donnels/aiwa-pb-3/README.asciidoc

= aiwa pb-3 battery replacement
:toc: right
:toclevels: 5
:sectnums:
:sectnumlevels: 5
:flag-book: true

USB-C rechargeable LiPo replacement for the AIWA PB-3/PB-4 battery pack.

[NOTE]
====
This is a personal project, not affiliated with or endorsed by AIWA.
This is my first outing with KICAD and PCB design; forgive stupidity and ignorance.
====

== Specs

|===
| Parameter | Original PB-3 | This Design
| Chemistry | Lead-acid | LiPo
| Cell voltage | 2V | 3.7V nominal
| Output voltage | 2V | 2.0V (adjustable 2.0-2.4V)
| Capacity | 470mAh | 500-1500mAh
| Charging | Proprietary | USB-C 5V
|===

== Safety

* Buck DC-DC steps 3.7V → 2.4V
* **OVP (Zener/TVS)** clamps output <3V if buck fails
* DW01A+FS8205A BMS: OV/UV/OC protection

== How This Book Is Built

This README is a step-by-step training example: it walks from raw
research to a working, physically- and electrically-compliant battery
pack, including the toolchain checks done along the way. Every step below
is its own `README.adoc` in its own directory, assembled here with
`include::` and `leveloffset` — nothing is a link, so the whole story
reads top to bottom in one document.

. *Research* — collect teardown photos, forum knowledge, and IC datasheets.
. *Measurements* — caliper the original pack and derive the mechanical envelope.
. *Design Notebook* — turn research and measurements into requirements.
. *KiCad Hello World* — prove the KiCad → KiBot → CI toolchain on a known-good project.
. *Mechanical Design* — OpenSCAD fit-check model of the envelope.
. *Circuit Design & Emulation* — KiCad schematic, component selection, ngspice model.
. *Architecture Diagrams* — PlantUML system diagrams.
. *Results & Compliance* — generated evidence that the design fits and works.

== Step 1: Research

include::research/README.adoc[leveloffset=+2]

== Step 2: Measurements

include::measurements/README.adoc[leveloffset=+2]

== Step 3: Design Notebook

include::pb3-notes.adoc[leveloffset=+2]

== Step 4: KiCad Hello World

include::kicad-hello-world/README.adoc[leveloffset=+2]

== Step 5: Mechanical Design (OpenSCAD)

include::openscad/README.adoc[leveloffset=+2]

== Step 6: Circuit Design & Emulation (KiCad)

include::kicad/README.adoc[leveloffset=+2]

== Step 7: Architecture Diagrams

include::images/README.adoc[leveloffset=+2]

== Step 8: Results & Compliance

include::results/README.adoc[leveloffset=+2]

== Architecture Decisions

include::adr/README.adoc[leveloffset=+2]

== Credits

* https://stereo2go.com/forums/threads/rechargeable-battery-replacement-for-aiwa-pb-3-pb-4.9025/[Stereo2Go forum] — original research
* OpenSCAD: https://github.com/donnels/openscad[ghcr.io/donnels/openscad:main]
* PlantUML: https://github.com/donnels/plantuml[ghcr.io/donnels/plantuml:main]
* KiBot: https://github.com/INTI-CMNB/KiBot[INTI-CMNB/KiBot@v2_dk8]

== Containerized builds

Every step in the `Build` workflow runs in a container — OpenSCAD,
PlantUML, KiCad, AsciiDoc, ngspice, and the GLB→STL board conversion.
Nothing installs directly on the runner. Generated renders, diagrams,
fabrication files, simulation logs, and documents are committed under
`results/`. Locally-built images (ngspice, trimesh) and their Dockerfiles
live in `containers/`, each with its own README.
