donnels/aiwa-pb-3/kicad/README.adoc

= Circuit Design & Emulation
ifndef::flag-book[]
:toc: right
:toclevels: 5
:sectnums:
:sectnumlevels: 5
endif::[]
ifdef::flag-book[]
:imagesdir-save: {imagesdir}
:imagesdir: kicad
endif::[]

`pb3-replacement.kicad_pro` (with its `.kicad_sch`/`.kicad_pcb`) is the
living electrical design for the replacement pack: a 68×17.8×8mm board that
takes USB-C 5V in and delivers a regulated 2.0-2.4V deck rail from a 1S
LiPo cell.

== Component Selection

Each part below was picked from the candidates surveyed in
`research/README.adoc`, chosen for SOT-23-6 footprints (small enough for
the enclosure) and for matching the behavior already proven on the clone
teardown boards.

CN3058E (charger)::
Linear Li-ion/LiPo charge management IC. Takes the USB-C 5V rail, applies
CC/CV charging to the cell, and needs only a handful of external passives
— important with almost no board area to spare.

DW01A + FS8205A (protection)::
Discrete battery management system on the cell tabs. DW01A senses cell
voltage and current; FS8205A is the dual N-MOSFET it drives to cut the
path on overvoltage, undervoltage, or overcurrent/short. Chosen instead of
trusting the charger or buck stage alone, so a fault anywhere downstream
still leaves the cell protected.

Buck regulator (TPS61023-class)::
Steps the ~3.7V cell rail down to the 2.0-2.4V the deck expects. The
feedback resistor sets the output: 100kΩ gives the PB-S5 clone's default
2.4V; the forum's 120kΩ swap gives 2.1V. Extrapolating those two points
puts 2.0V at roughly 130kΩ — an unverified estimate, not a datasheet
value. `pb3-architecture-sizing.cir` models 2.0V directly; confirm the
real resistor against the vendor datasheet and bench measurement before
fabrication.

OVP clamp (Zener/TVS)::
Added on top of what the clone boards do: clamps the output below 3V if
the buck stage fails, so the deck never sees the raw 3.7V cell rail.

== Circuit Emulation

Emulation happens in two stages so a passing simulation always means
something about the *real* board, not just about an idealized stand-in.
See `pb3-notes.adoc`'s "Verification Chain" for how this fits the
project's broader print/fit/design/verify sequence.

=== Stage 1 — Architecture Sizing (exploratory, not a verification)

`pb3-architecture-sizing.cir` is a system-level ngspice model used to
pick topology and nominal values *before* the schematic below existed.
It approximates the CN3058E charger, 1S LiPo, DW01A/FS8205A protection,
2.0V buck regulator, 200mA deck load, and output clamp with behavioral
sources (idealized voltages/thresholds, not real part models). It is
useful for checking operating points and assumptions. It does **not**
validate the real IC compensation network, stability, thermal behavior,
the unverified AIWA connector pinout, or — critically — the actual
schematic/PCB below: the netlist is hand-written, independent of
`pb3-replacement.kicad_sch`, so a passing run only proves the idealized
model is self-consistent.

Run it with ngspice:

[source,bash]
----
ngspice -b -o pb3-architecture-sizing.log pb3-architecture-sizing.cir
grep -E 'vout_|load_current|vbat' pb3-architecture-sizing.log
----

Expected results: ~1.98V at the deck output, 198mA load current, 3.7V
at the idealized cell. The model hard-codes a 2.0V buck target — it
does not use the ~130kΩ feedback-resistor estimate above, which is for
the real IC's feedback divider, not this behavioral model.

=== Stage 2 — Schematic-Derived Simulation (netlist export unblocked; full SPICE sim still partial)

The step that actually verifies the design generates a SPICE netlist
*from* `pb3-replacement.kicad_sch` (`kicad-cli sch export netlist
--format spice`) and simulates it with real or vendor-published SPICE
models for `U1` (TP4056), `U2` (DW01A), `Q1` (FS8205A substitute, see
below), `U3` (TPS62200), and `D1` (Zener) wherever such models exist.
That checks the same reference designators and values that get
fabricated, closing the gap that Stage 1 leaves open.

`pb3-replacement.kicad_sch` is now a real, pin-wired schematic instead of
a block/documentation diagram: every component is a real KiCad library
symbol (embedded in `lib_symbols`), and every pin is tied to its net via a
same-named global label placed at the pin, reusing the exact net names
already routed on the PCB (`VBUS`, `VBAT`, `VBAT_RAW_NEG`, `GND`,
`OD`/`OC`) plus new nets for the passives the PCB was missing (see "PCB
Routing" below). `kicad-cli sch erc` on this schematic reports **0
errors** (down from 19 dangling/unconnected errors on the old block
diagram); the remaining ~40 warnings are expected/documented — footprint
library-table warnings from running outside a configured KiCad project,
`NC_*` single-pin nets that are intentionally left dangling (documented
below), and off-grid cosmetic placements from the label-per-pin layout
strategy.

Three of the schematic's original `lib_id`s did not just lack wiring —
they were **unresolvable against real KiCad libraries** and would have
failed to open cleanly in KiCad at all. They were corrected to real,
pin-compatible library parts:

* `Battery_Management:TP4056` → `Battery_Management:TP4056-42-ESOP8`
  (same SOIC-8 pinout already used for PCB routing).
* `Regulator_Switching:TPS62200` → `Regulator_Switching:TPS62200DBV`
  (same SOT-23-5 pinout already used for PCB routing).
* `Connector:USB_C_Receptacle_USB2.0` → `Connector:USB_C_Receptacle_PowerOnly_6P`
  (matches the existing 6-pad `GCT_USB4105-xx-A` footprint already
  placed on the PCB; note the CC1/CC2 pins are wired to `NC_CC1`/`NC_CC2`
  — proper USB-C power-only negotiation needs 5.1kΩ pull-downs on both,
  which this revision does not add — a newly-discovered, real gap,
  documented here rather than fixed silently).
* `Transistor_FET:FS8205A` does not exist in any public KiCad library.
  `Transistor_FET:DMG9926UDM` (a real Diodes Inc. common-drain dual
  N-MOSFET, SOT-23-6) is used as a documented substitute: its pin
  numbering (1=D1, 2/5=common S1/D2, 3=S2, 4=G2, 6=G1) maps pin-for-pin
  onto the FS8205A pinout already cited in "PCB Routing" below. This is a
  schematic-symbol substitution for simulation/ERC purposes only — it
  does not change which part is fabricated.

Exporting the netlist now succeeds structurally
(`kicad-cli sch export netlist --format spice`), where it previously had
nothing valid to export. It is **still not a fully simulatable SPICE
netlist**: `kicad-cli`'s built-in SPICE exporter only resolves passives
(`R`/`L`/`C`) by reference-designator convention; multi-pin parts
(`U1`/`U2`/`Q1`/`U3`/diodes/connectors) need `Sim.Device`/`Sim.Pins`/
`Sim.Model` fields added per-symbol before ngspice can use them, and two
of those parts have no public SPICE model to attach in the first place
(DW01A, FS8205A/DMG9926UDM) — the same documented gap Stage 1 already
calls out. Adding those Spice fields for the parts that do have public
models (TPS62200, and third-party TP4056 models) is the concrete next
step to get from "netlist exports" to "netlist simulates."

Verify with vendor SPICE models and bench measurements before connecting
an AIWA deck. This is the electrical half of the compliance check; the
mechanical half is the OpenSCAD fit check.

=== Interactive Exploration & Physical POC Loop

CI only ever runs `ngspice -b` (batch mode): fixed inputs in, a log file
out, useful for a pass/fail gate but not for poking at the circuit. Use
an interactive ngspice session to explore *before* trusting a number:

[source,bash]
----
docker run --rm -it -v "$PWD/kicad":/work -w /work --entrypoint ngspice \
  aiwa-pb3-ngspice pb3-architecture-sizing.cir
----

At the `ngspice>` prompt:

* `run` — execute the `.tran` analysis already in the file.
* `plot v(vout) v(bat) v(bms)` — waveform the deck output, cell, and
  protected-rail nodes against each other.
* `alter vbat = 3.5` / `alter rload = 20` then `rerun` — sweep a
  parameter (end-of-discharge cell voltage, heavier deck load) without
  editing the file and re-running batch.
* `iplot vout` before `run` — live-updating plot while the transient
  computes, useful for long sweeps.

This is where the model's idealizations get tested on purpose: try to
`alter` the OVP/UV thresholds in `pb3-architecture-sizing.cir` to
something that should visibly fail and see if the behavioral `B` sources
even react with a realistic shape (delay, ringing, hysteresis) or just
snap instantly. A too-clean reaction is the signal that a part is not
meaningfully simulated yet — currently true for the DW01A/FS8205A
trip behavior and the TPS62200 loop response (see the model's own
comments).

**Graphical tools for exploring the circuit:**

* *ngspice's own plotting* — if built with X11/Qt support (the Debian
  `ngspice` package used by `containers/ngspice/Dockerfile` is), `plot`/
  `iplot` open native graph windows. Run the container with `-it` and
  forward the display (`-e DISPLAY=$DISPLAY -v /tmp/.X11-unix:/tmp/.X11-unix`
  on Linux) instead of running headless.
* *Xschem + ngspice* — free schematic-capture front end that drives
  ngspice directly: draw the circuit, click a wire/pin to place a probe,
  hit simulate, see the waveform in the same window. Good for exploring
  the TP4056/DW01A/FS8205A/TPS62200 topology graphically without waiting
  on Stage 2's KiCad netlist export.
* *QUCS-S* — schematic capture with ngspice as its simulation backend
  and a built-in interactive waveform viewer; another schematic-first
  alternative to hand-editing `.cir` files.
* *KiCad's own "Simulate" tab* (eeschem, ngspice-integrated) — click a
  net on the schematic to probe it interactively. The schematic now has
  real pin-to-pin wiring (see Stage 2 above), so this is usable for
  probing net connectivity; full transient simulation in this tab still
  needs the same per-symbol Spice model fields called out in Stage 2.

**Turning an exploration finding into a physical POC:** when interactive
exploration flags a node ngspice can't be trusted for — DW01A/FS8205A
trip voltage and timing, TPS62200 transient response under a real deck
load step, the Zener/TVS clamp's actual knee — build the smallest
dead-bug/breadboard rig that isolates just that question, using the real
part: bench supply standing in for the cell, a scope on the node in
doubt, a load step or ramp matching what the deck actually does. Measure
it, then fold the number back into `pb3-architecture-sizing.cir` (replace
the idealized threshold/step in the relevant `B` source) with a comment
citing the POC measurement, so the next simulation run reflects reality
instead of an assumption. See `pb3-notes.adoc`'s "Verification Chain" for
where this loop sits relative to Stage 1/Stage 2/bench test.

== PCB Routing

`pb3-replacement.kicad_pcb` places footprints for the 1S protection/buck
power path (`J1` USB-C, `U1` TP4056 charger, `U2` DW01A protection IC,
`Q1` FS8205A dual-FET, `U3` buck regulator, `J2` deck connector, `BT1`
LiPo cell). `pb3-replacement.kicad_sch` is now a real, pin-wired
schematic (see "Circuit Emulation" → Stage 2 above) that documents the
same pinouts used for PCB routing below, so this section and the
schematic no longer disagree with each other. Nets and copper traces on
the PCB were still added directly (not derived from the schematic, since
KiCad's PCB-from-schematic re-annotation was not run this pass) using
verified, datasheet-cited pinouts for the actual parts placed on the
board:

* TP4056 (SOIC-8): 1=TEMP, 2=PROG, 3=GND, 4=VCC, 5=BAT, 6=~STDBY, 7=~CHRG, 8=CE.
* DW01A (SOT-23-6): 1=OD, 2=CS, 3=OC, 4=TD, 5=VCC, 6=GND — cross-checked
  against Fortune Semiconductor datasheet DW01A-DS-12_EN Rev 1.2, Section 6.
* FS8205A (SOT-23-6): 1=S1, 2/5=D12 (common drain), 3=S2, 4=G2, 6=G1. The
  schematic's `Q1` symbol is `DMG9926UDM` (documented substitute, see
  Stage 2 above) with the same pin mapping.
* TPS62200DBV (SOT-23-5): 1=VIN, 2=GND, 3=EN, 4=FB, 5=SW. The PCB
  footprint is labelled `TPS61023`, but the real TI TPS61023 is a 6-pin
  SOT-563 part that doesn't match this board's 5-pad SOT-23-5 footprint.
  The schematic's actual symbol for `U3` is `Regulator_Switching:TPS62200DBV`
  (a real SOT-23-5 buck), so the TPS62200 pinout was used to route the 5
  pads that exist — the footprint name is a pre-existing naming
  inconsistency in the repo, left unchanged.

Routed nets: `VBUS`, `GND` (includes TEMP/CE tied low and the
DW01A/FS8205A current-sense node), `VBAT` (cell/protected-positive rail,
includes `EN` tied high for an always-on regulator), `VBAT_RAW_NEG`
(raw/unprotected cell negative — kept separate from `GND` so the
protection circuit still does its job), and the DW01A→FS8205A gate
signals `OD`/`OC`.

Several pins are still left as single-pad, unrouted `NC_*` nets on the
**PCB** (`NC_PROG`, `NC_STDBY`, `NC_CHRG`, `NC_TD`, `NC_FB`, `NC_SW`,
`NC_VOUT`) because the passives their function depends on — the PROG
resistor (`R2`), charger status LEDs (`D2`/`D3`) with their current-limit
resistors (`R3`/`R4`), the buck's inductor (`L1`), the FB feedback
divider's second resistor (`R5`), and the output capacitor (`C1`) — have
footprints in the schematic now (used for Stage 2 netlist export) but
**not yet as PCB footprints/copper on this tight 68×17.8mm board**.
`kibot.yaml`'s `ignore_unconnected` preflight option keeps DRC clean
despite this. Placing and routing those 6 new footprints (`R2`-`R5`,
`L1`, `C1`, plus `D2`/`D3` LEDs) is the concrete next task to close this
gap — precisely scoped now that the schematic fixes their values and net
names, but not attempted in this pass given the board's limited area.

Component values chosen for the schematic (flagged by confidence level,
not asserted as final):

* `R2` (PROG) = 2.4kΩ — derived from the TP4056 datasheet formula
  `Ichg(mA) = 1200/Rprog(kΩ)` for a 500mA charge target.
* `L1` = 2.2µH — taken directly from `pb3-notes.adoc`'s existing
  Electrical Block Requirements.
* `R3`/`R4` (LED current-limit) = 1kΩ — generic placeholder, **not
  verified** against the LED's actual forward-current spec.
* `R5` (FB divider bottom resistor) = **TBD** — left unset; the TI
  TPS62200 datasheet was not reachable this session to derive it from
  `R1`'s ~130kΩ estimate above using the real feedback-voltage formula.
* `C1` (buck output cap) = 10µF — generic typical value, **not verified**
  against the TPS62200 datasheet's stability requirements.

This is a best-effort prototype routing based on standard reference-design
pinouts, not a verified production layout — confirm every net against the
real datasheets and bench-test before fabrication, same as the existing
disclaimers on connector pinout and the feedback resistor value above.

== 3D Exports & Renders

Alongside the fabrication outputs (gerbers, drill, position files),
`kicad-cli` (KiCad 9, `pcb export`/`pcb render`) produces:

* `pb3-replacement.step` — STEP solid model, for any MCAD tool.
* `pb3-replacement.glb` — binary glTF, converted to
  `results/cad/pb3-replacement-board.stl` by the `containers/trimesh`
  container (rescale, re-axis, re-origin — see its README).
* `pb3-replacement-render-top.png` / `-render-iso.png` — photorealistic
  raytraced renders of the finished board.

.Isometric render of the replacement board


The STL feeds `openscad/pb3-fit-check.scad` — see "Mechanical Design
(OpenSCAD)" for the fit-check render.

== Free Training & Docs

* https://github.com/KiCad/kicad-source-mirror[KiCad source (GitHub mirror)] —
  official KiCad source code; the repository README links to the free
  documentation site.
* https://github.com/joanbono/awesome-kicad[awesome-kicad] — curated list
  of free KiCad tutorials, plugins, and libraries.
* https://github.com/ngspice/ngspice[ngspice] — official circuit
  simulator source and documentation used by "Circuit Emulation" above.
* https://github.com/kitspace/awesome-electronics[awesome-electronics] —
  curated list of free datasheets, application notes, and component
  selection references, useful background for "Component Selection".
* https://github.com/KhronosGroup/glTF[glTF specification] — the format
  behind the `.glb` export used for the mechanical fit-check.

//END OF DOC
ifdef::flag-book[]
:imagesdir: {imagesdir-save}
endif::[]
