donnels/aiwa-pb-3/pb3-notes.adoc

= PB-3 Reverse-Engineering Notebook
// PB-3 Reverse-Engineering Notebook
// Included in README.asciidoc
// Do not render standalone
// This file lives at repo root and its image paths (e.g. openscad/pb3-pack.png)
// are already root-relative, so no imagesdir save/override/restore is needed here.
ifndef::flag-book[]
:toc: right
:toclevels: 5
:sectnums:
:sectnumlevels: 5
endif::[]

== Objective
Build a present-day PB-3 pack that wakes an AIWA HS-PC202MII. That deck is the primary test bed and end user. The wall wart is missing, the stock SLA is dead, and donor packs only exist as forum photos, so every measurement and assumption comes from images plus clone teardowns.

== What is Known Today
[cols="2,4,4"]
|===
|Topic | Details | Confidence

|Mechanical envelope
|Caliper photos show 68 mm × 17.8 mm × 8 mm overall and a 52 mm × 15 mm × 6 mm cell bay. Thin plastic shell, PCB island at the connector end with fuse and ballast resistor.footnote:meas[In-house photo set `measurements/IMG_9373.jpeg`–`IMG_9385.jpeg`.]
|High. Need one more sample to average tolerance.

|Electrical interface
|Two-pin keyed blade plus PB-4 top pads. Clone pack shows 3.67 V LiPo feeding a converter that outputs 2.41 V on the blades; wiring solders directly to the IC pins.footnote:s2g[] HS-PC202MII schematic is unavailable, so reverse engineering relies on photos and continuity tests once the clone arrives.
|Low. Need deck-side schematic to confirm charge routine and pinout.

|Chemistry and capacity
|Original PB-3 spec sheet rated 470 mAh SLA. Community teardowns hint at 700–800 mAh service packs, but clones today ship 500 mAh LiPo with buck down to 2.4 V.footnote:s2g[]
|Medium. Need an unopened OEM cell for proof.

|Community precedents
|Baidu and Stereo2Go builds use 3D-printed shells plus Li-ion or LiPo stages, usually without fault clamps or plated blades.footnote:s2g[]
|High. Reuse photos only with permission.
|===

== Research Findings

=== Stereo2Go thread highlights
* AliExpress PB-3/PB-4 USB-C pack runs £14, lists 900 mAh, hides 500 mAh LiPo, spits 3.67 V raw and 2.41 V at the blades.footnote:s2g[Rossoe et al., "Rechargeable battery replacement for AIWA PB-3 / PB-4," Stereo2Go forums, Sep 2023–Apr 2025. Offline copy: `research/Rechargeable battery replacement for AIWA PB-3 _ PB-4 _ Stereo2Go forums.html`. Original URL: https://stereo2go.com/forums/threads/rechargeable-battery-replacement-for-aiwa-pb-3-pb-4.9025/]
* Shell size is 68 mm × 17.8 mm × 8 mm. Battery cavity maxes at 52 mm × 15 mm × 6 mm, so 500 mAh is the ceiling until cells improve.footnote:s2g[]
* 3D printed case flexes, screw bosses die fast, only top contacts get plating.footnote:s2g[]
* Pack leads land right on converter pins. Bare copper hovers over inductors. No strain relief.footnote:s2g[]
* If the buck converter fails, the deck eats the full 3.7 V. Need a clamp or crowbar that kills the fault.footnote:s2g[]
* PB-S5 board is the same. Swap the marked 100 kΩ resistor for 120 kΩ to hit 2.1 V. 0603 footprint.footnote:s2g[]
* Search phrase "500mAh lipo battery 6mm" finds cells that fit; nothing larger ships yet.footnote:s2g[]
* Wickedkraft sells a pricier variant on eBay. No autopsy yet but likely the same guts.footnote:s2g[]

=== Derived Requirements
* USB-C charging. Retire the fragile Aiwa wall wart.footnote:s2g[]
* Runtime must beat the 470 mAh SLA. Target >900 mAh effective at 2V output.footnote:s2g[]
* Respect 68 mm × 17.8 mm × 8 mm overall and 52 mm × 15 mm × 6 mm cell cavity. Keep PB-4 top contacts alive.footnote:s2g[]
* Plate every blade. Reinforce the connector window so owners stop snapping plastic.footnote:s2g[]
* Terminate the cell on pads with relief. No bare wires surfing active parts.footnote:s2g[]
* Add a fault clamp so output never drifts past 2.4 V even if the buck fails. Make PB-S5 vs PB-3 voltage a resistor change.footnote:s2g[]

== Host Deck Reality
* Runner: AIWA HS-PC202MII. This deck will see every prototype first and is the reason the project exists.
* Constraints: OEM wall wart is missing, OEM PB-3 pack is dead, and voltage measurements of it are not relevant (0v). Reverse engineering starts with images of clone PCBs.

== Research To-Do List
. **Imagery**: pull clean teardown photos from Baidu Tieba (`随身听 PB-3`) and Japanese blogs. Capture rulers or redraw.
. **Connector survey**: borrow a PB-3 pack or host deck. Log pitch, depth, retention, plating.
. **Power sweep**: record float voltage, discharge curve, deck charge current while the donor SLA still lives (if there is one which there isn't).
. **Archive**: dump every measurement, photo, and trace into this repo before CAD starts.

== Proposed Replacement Strategy
SLA is dead weight. Teardown of Aliexpress clone confirms the working approach.

*LiPo 1S (3.7V nominal) + buck to 2.0V*::
+ Matches existing clone design (LAOWANG_DIY board)
+ 500mAh cell → 900mAh effective at 2V output
+ Buck topology (step-down) matches 3.7V→2.0V requirement
+ BMS often on cell flex PCB

Baseline design: **1S LiPo 500mAh + buck converter regulated at 2.0V** matching the original PB-3 output.

== Electrical Block Requirements
* Cell: 500mAh LiPo pouch, ~6mm thick, matches 52×15×6mm cavity
* BMS: On cell flex PCB (clone) or discrete DW01A+FS8205 (our design)
* Buck: SOT-23-6 IC, 2.2µH inductor, configured for 2.0V output
* Rfb: 100k = 2.4V, 120k = 2.1V (per Stereo2Go mod). Adjust for 2.0V target.
* Charge path: USB-C 5V → charger IC (SOT-23-6) → CC/CV 4.2V to cell
* OVP: Zener/TVS clamp <3V to protect deck if buck fails (improvement over clone)

== Mechanical Considerations
* Stay inside the original outline so the bay latch still works. 0.8 mm FR-4 maximizes cell room.
* Scan or caliper a donor shell. Build a STEP model for interference checks.
* Reuse the original keyed blade if possible. If not, design a flex tail or custom edge connector footprint.
* Rough CAD now lives in `openscad/pb3-pack.scad` (OpenSCAD). Dimensions trace back to `measurements/IMG_9373.jpeg`–`IMG_9385.jpeg` plus the Stereo2Go thread captured in `research/`.

.First Solid CAD Model
[source,scad]
----
include::openscad/pb3-pack.scad[]
----

.output image


== Living CAD + Automation
* `openscad/pb3-pack.scad` is the print gauge. Version is embossed on the block so prints always tell you which assumption set they follow.
* `kicad/pb3-replacement.kicad_pro` (plus `.kicad_sch`/`.kicad_pcb`) tracks the electrical build. It is tagged V0.1 in the title blocks so KiCad exports line up with the physical gauges.
* `.github/workflows/cad-build.yml` is the single entry workflow. Jobs: `openscad`, `plantuml`, `kicad` → `publish` which copies artifacts into `docs/generated/` and commits.

== Reverse-Engineering Workflow
. De-pot a PB-3 with heat and patience. Photograph each layer.
. Trace the PCB. Mark every component, resistor, and fuse.
. Recreate the old schematic in KiCad. Understand what the deck expects before changing it.
. Map new requirements against the host behavior.
. Draft hierarchical KiCad sheets: Cell+BMS, Buck, Connector/NTC. Assign refs early.

== Future KiCad Artifacts
* `kicad/pb3-replacement.kicad_pro` — full project.
* `mechanical/pb3-shell.step` — shell model for fit checks.
* `library/connector_aiwa_pb3.kicad_mod` — blade footprint.

== Verification Chain
Each step in the road to a fabricated board is meant to verify the step
before it, not stand alone. Simulation and physical test are chained,
not two disconnected box-ticks:

. *Sizing model* (`kicad/pb3-architecture-sizing.cir`, Stage 1) — decides
  topology and nominal values (1S LiPo, 2.0V buck output, 2.7V OV
  threshold) before any schematic exists. Behavioral, idealized, useful
  for picking numbers — not a check of the real circuit.
. *Interactive exploration + dead-bug POC loop* (optional, between Stage
  1 and the schematic) — run the sizing model interactively in ngspice
  (or a graphical front end) to find nodes the behavioral model can't be
  trusted for (protection IC trip behavior, buck transient response),
  then build the smallest physical dead-bug/breadboard rig with the real
  part to measure that node, and fold the measurement back into the
  `.cir` file. See "Interactive Exploration & Physical POC Loop" in
  `kicad/README.adoc`.
. *Schematic* (`kicad/pb3-replacement.kicad_sch`) — carries those same
  nominal values forward into a design with real parts (TP4056, DW01A,
  a documented DMG9926UDM substitute for the unavailable FS8205A symbol,
  TPS62200DBV, Zener). Now real, pin-to-pin wired with corrected/real
  `lib_id`s and 0 `kicad-cli sch erc` errors — see `kicad/README.adoc`'s
  "PCB Routing" and "Circuit Emulation" → Stage 2 sections for the exact
  substitutions made and the still-open PCB-footprint gap (`R2`-`R5`,
  `L1`, `C1`, `D2`/`D3` exist in the schematic but not yet on the PCB).
. *Netlist-derived sim* (Stage 2, netlist export unblocked; full SPICE
  sim still partial) — `kicad-cli sch export netlist --format spice` now
  produces a real netlist from the schematic instead of nothing. Passives
  (`R`/`L`/`C`) resolve automatically; multi-pin ICs still need
  `Sim.Device`/`Sim.Pins`/`Sim.Model` fields added per-symbol before
  ngspice can simulate them, and DW01A/FS8205A substitute have no public
  SPICE model to attach regardless — see `kicad/README.adoc` and
  `containers/ngspice/README.adoc` for the exact remaining steps.
. *Bench measurement* — once a board is built, measure the same
  quantities (deck output voltage, load current, OV cutoff point) called
  out in Stage 1/2 and log the delta here. A delta flags either a bad
  sizing assumption, a missing vendor model, or a real fault — not a
  simulation to ignore.

Same as the mechanical chain (print the gauge block, verify the fit,
only then route the board), no stage's pass/fail claims more than it
tests: a circuit that hits 2.0V in `pb3-architecture-sizing.cir` proves
the idealized model balances, nothing about the TP4056/DW01A/FS8205A/
TPS62200 board until Stage 2 or the bench confirms it too.

== Validation & Test Plan
*Functional*
* Charge through USB-C. Log voltage and current curves.
* Run a hungry deck like HS-PX505. Verify buck holds 2.0V ±0.1V during FF/REW.
* Measure output with multimeter: target 2.0V (orig PB-3) or 2.4V (clone default).

*Safety*
* Bake at 40 °C ambient. Keep silicon <85 °C.
* Trip short-circuit protection under 20 ms.

*Documentation*
* Export schematic PDFs and BOM straight from KiCad.
* Keep PlantUML diagrams in `images/` so architecture matches the board.

== Open Questions
* Do any decks sniff a third pin? Need proof before adding logic.
* Does the host trickle charge while on AC? Impacts design.
* Did Aiwa rely on SLA resistance rise for end-of-life? Might need a small gauge IC to mimic it.

== Next Immediate Steps
. Source a PB-3 donor for teardown.
. Measure connector plating and friction.
. Spin initial KiCad sheets with placeholders.
. Prototype the buck on eval hardware and log noise against the audio path.

== Free Training & Docs

* https://github.com/adr/madr[MADR — Markdown Architectural Decision
  Records] — the format this notebook's decisions loosely follow, free
  and GitHub-hosted.
* https://github.com/kitspace/awesome-electronics[awesome-electronics] —
  same curated datasheet/reference list cited from the Research step,
  useful when re-checking an open question against a component datasheet.

//END OF DOC
