donnels/aiwa-pb-3/images/README.adoc

= PlantUML Diagrams
ifndef::flag-book[]
:toc: right
:toclevels: 5
:sectnums:
:sectnumlevels: 5
endif::[]
ifdef::flag-book[]
:imagesdir-save: {imagesdir}
:imagesdir: images
endif::[]

== PB3Architecture

.`PB3Architecture`
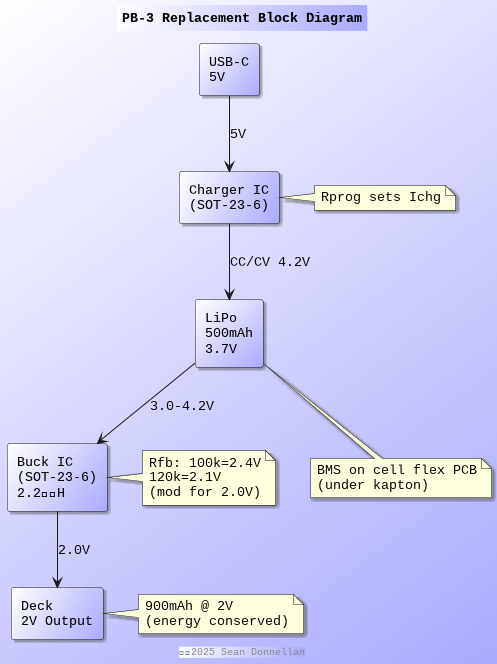
[picture p5: images/PB3Architecture.png]


link:PB3Architecture.svg[SVG] 
link:PB3Architecture.png[PNG]

== Free Training & Docs

* https://github.com/plantuml/plantuml[PlantUML] — official project
  repository and documentation for the diagram-as-code syntax used here.

ifdef::flag-book[]
:imagesdir: {imagesdir-save}
endif::[]
