donnels/aiwa-pb-3/research/PB3-f.jpg

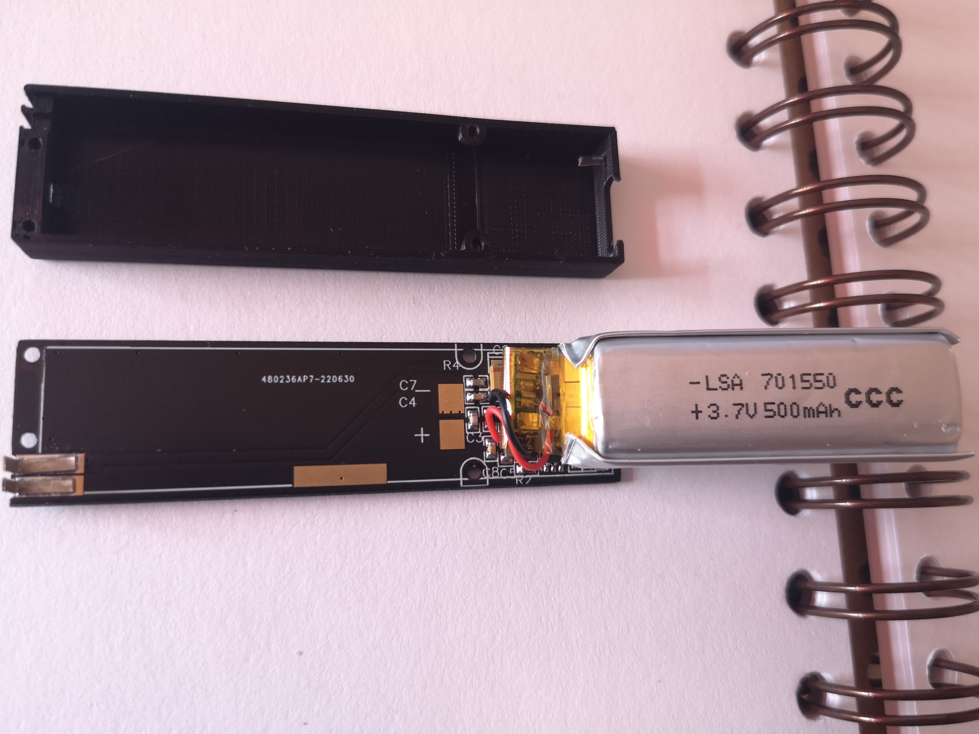
research/PB3-f.jpg
