donnels/aiwa-pb-3/research/PB-3b.jpg

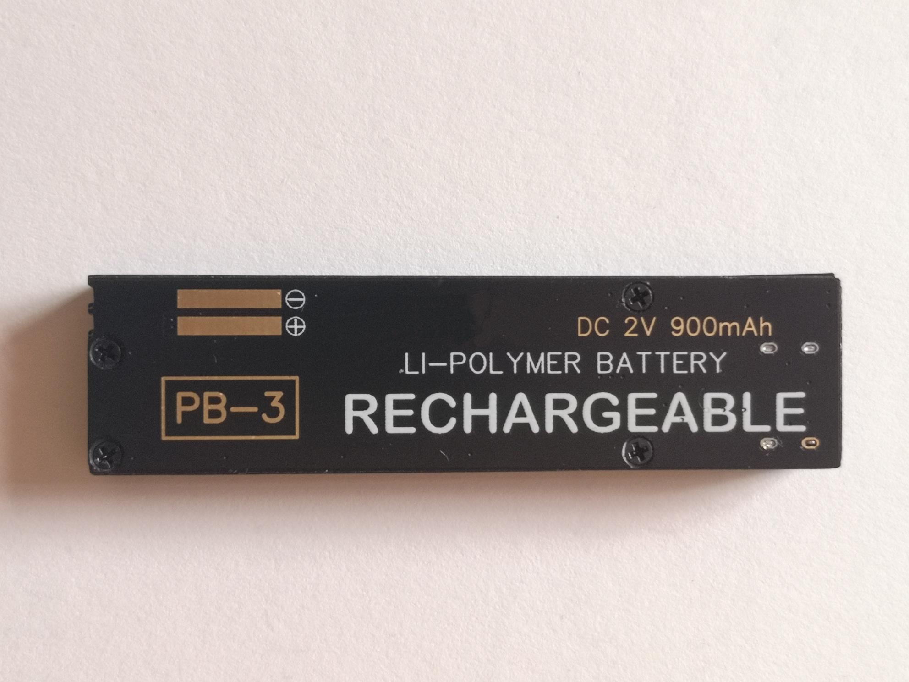
research/PB-3b.jpg
