donnels/aiwa-pb-3/research/PB-3c.jpg

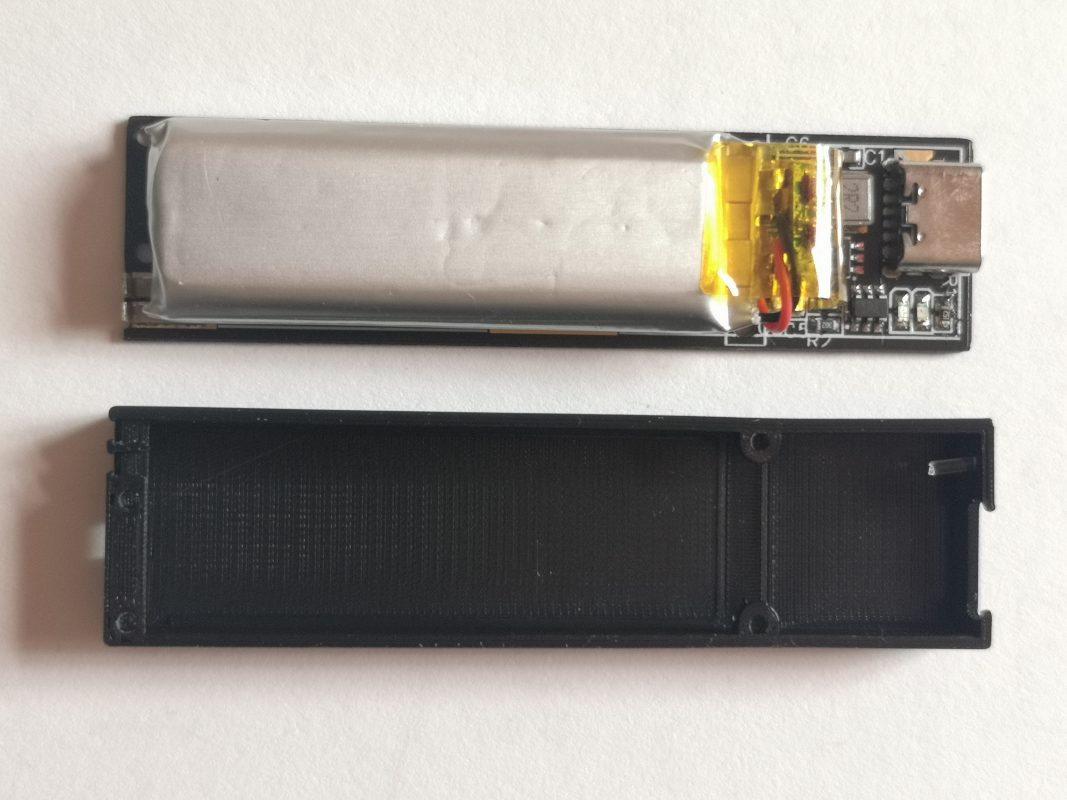
research/PB-3c.jpg
