donnels/aiwa-pb-3/research/PB-3d.jpg

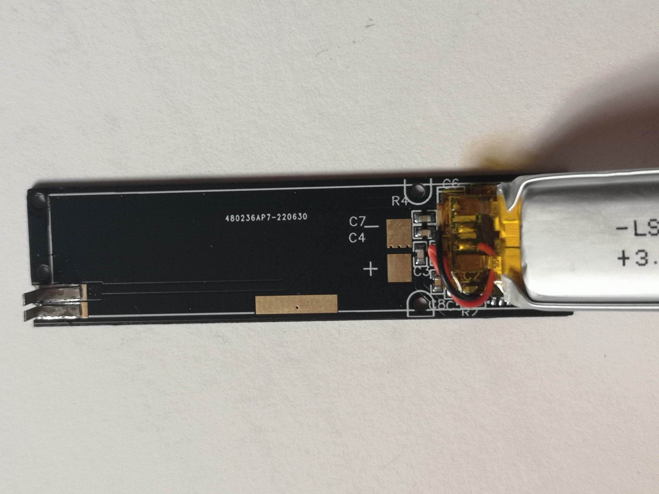
research/PB-3d.jpg
