donnels/aiwa-pb-3/research/PB-3e.jpg

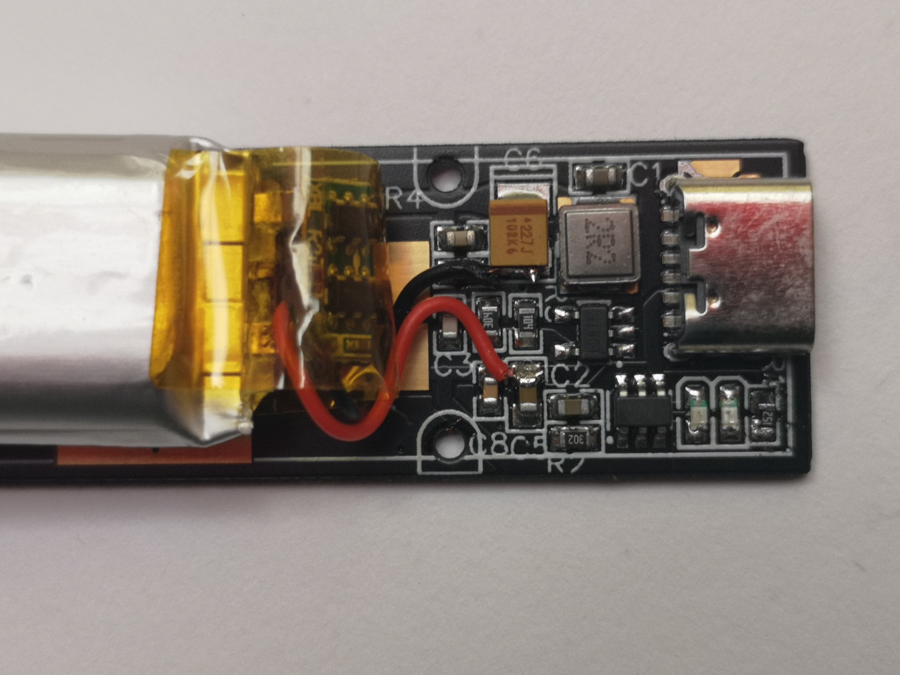
research/PB-3e.jpg
