donnels/aiwa-pb-3/research/PB-S5b.jpg

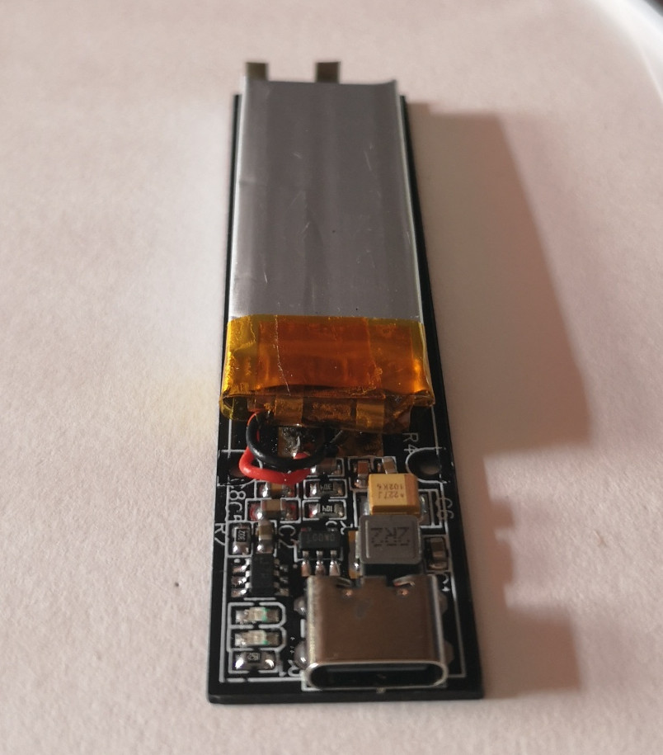
research/PB-S5b.jpg
