donnels/aiwa-pb-3/research/PB-S5c.jpg

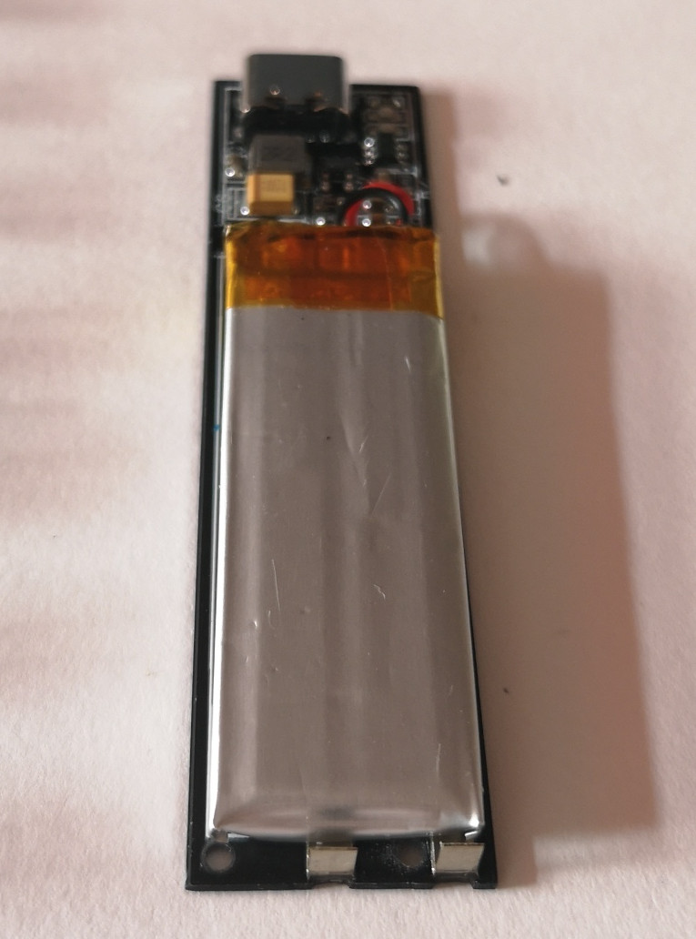
research/PB-S5c.jpg
