donnels/aiwa-pb-3/research/PB-S5d.jpg

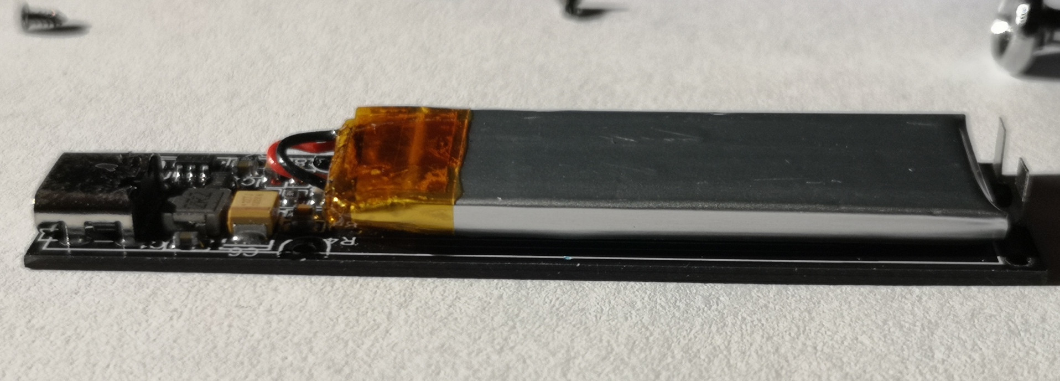
research/PB-S5d.jpg
