donnels/aiwa-pb-3/research/PB-S5e.jpg

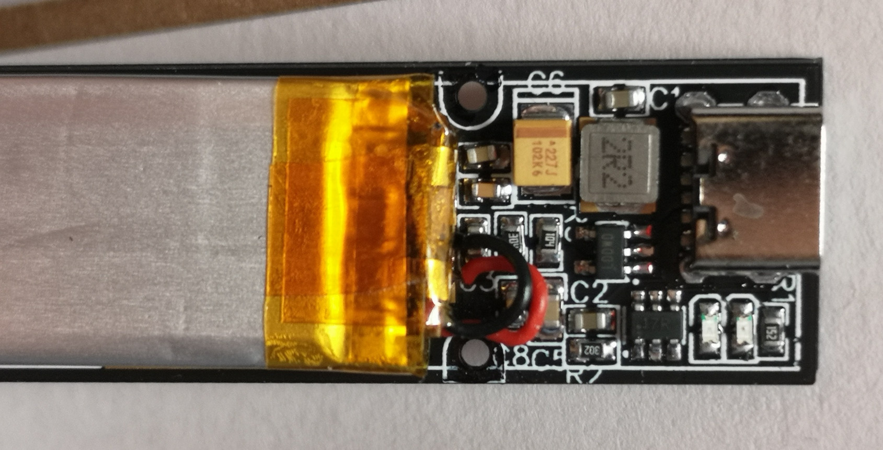
research/PB-S5e.jpg
