donnels/aiwa-pb-3/research/PB-S5f.jpg

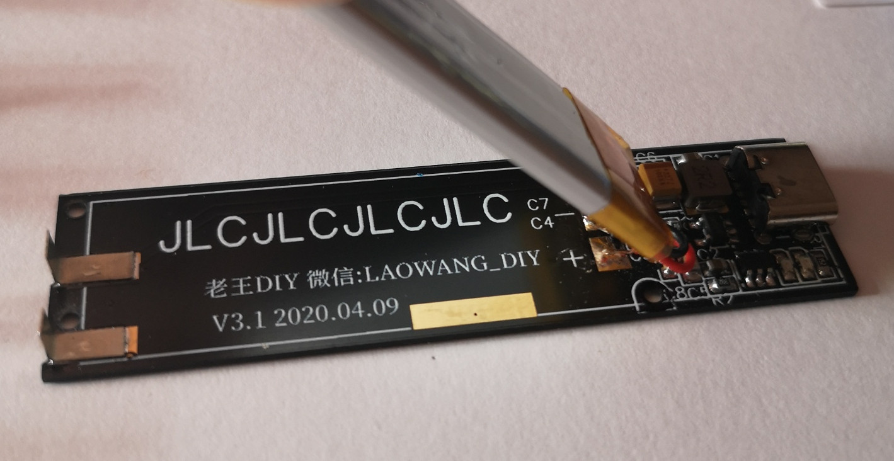
research/PB-S5f.jpg
