donnels/aiwa-pb-3/research/PB-S5g.jpg

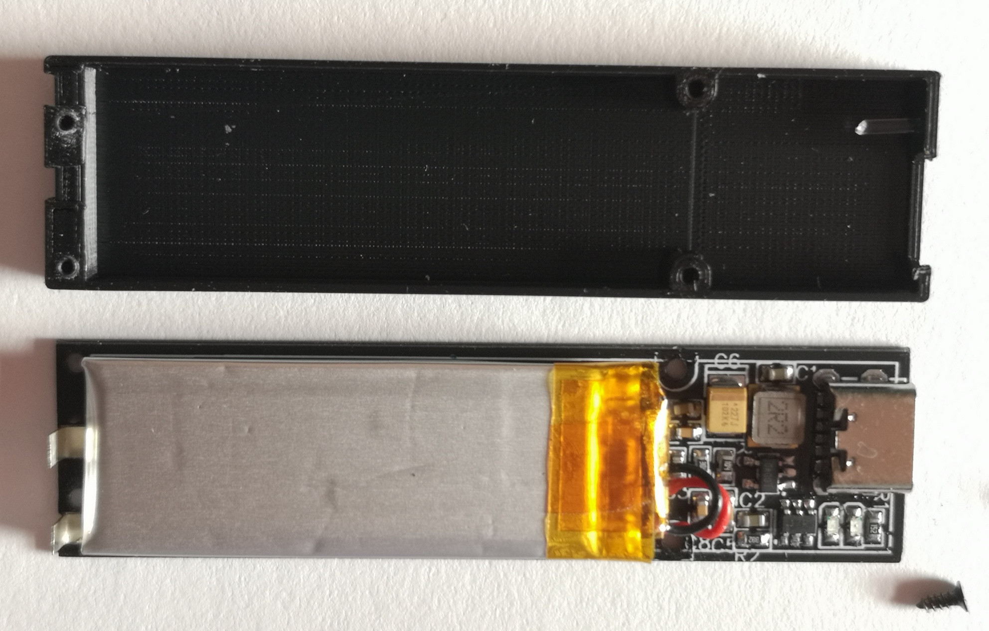
research/PB-S5g.jpg
