donnels/aiwa-pb-3/research/PB-S5h.jpg

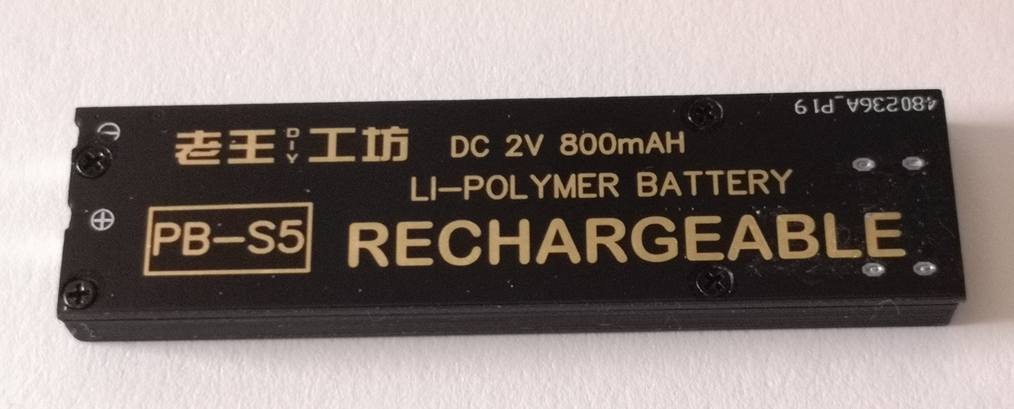
research/PB-S5h.jpg
