donnels/aiwa-pb-3/research/PB-S5j.jpg

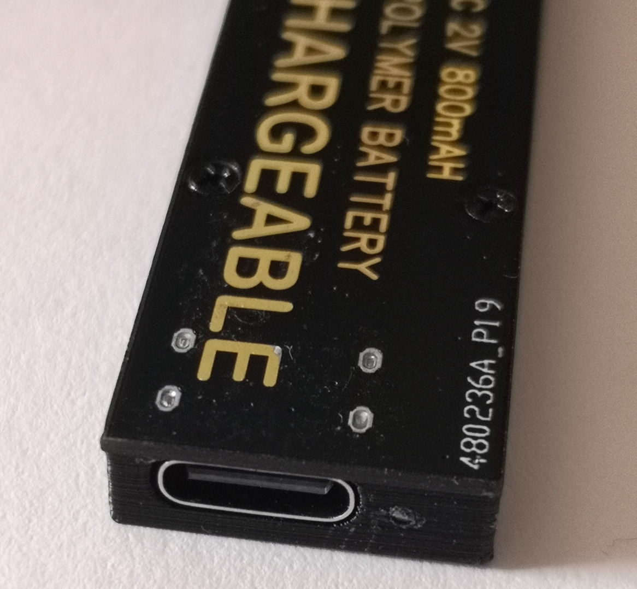
research/PB-S5j.jpg
