donnels/aiwa-pb-3/research/PB-S5k.jpg

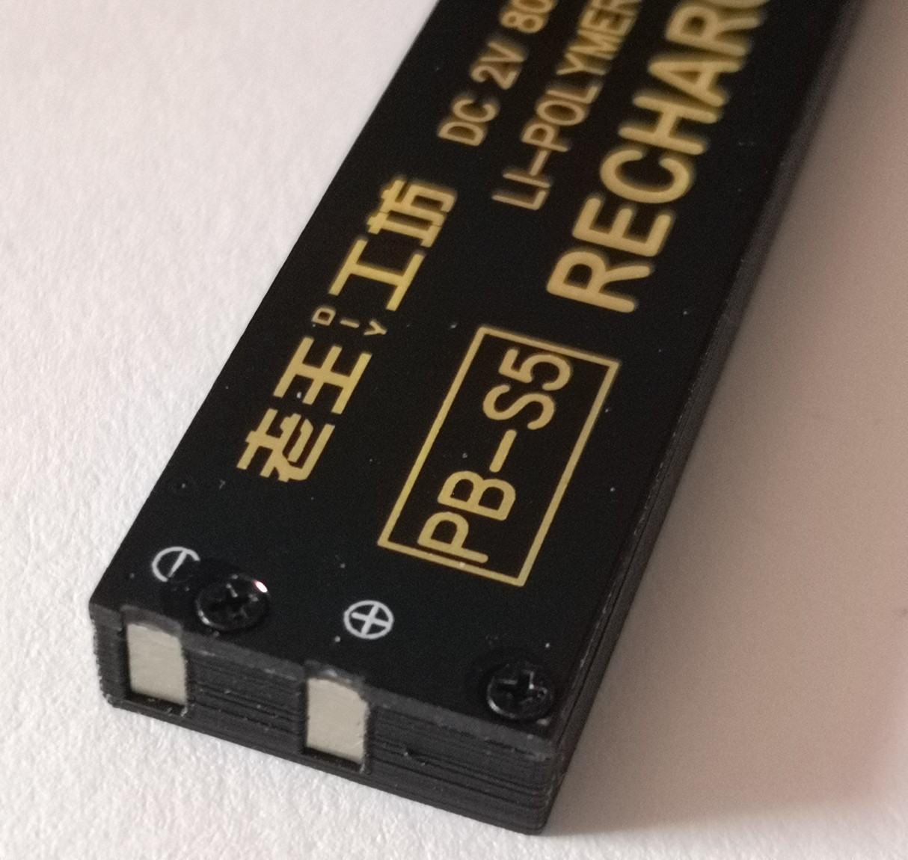
research/PB-S5k.jpg
