donnels/aiwa-pb-3/research/upload_2023-10-1_13-9-23.jpeg

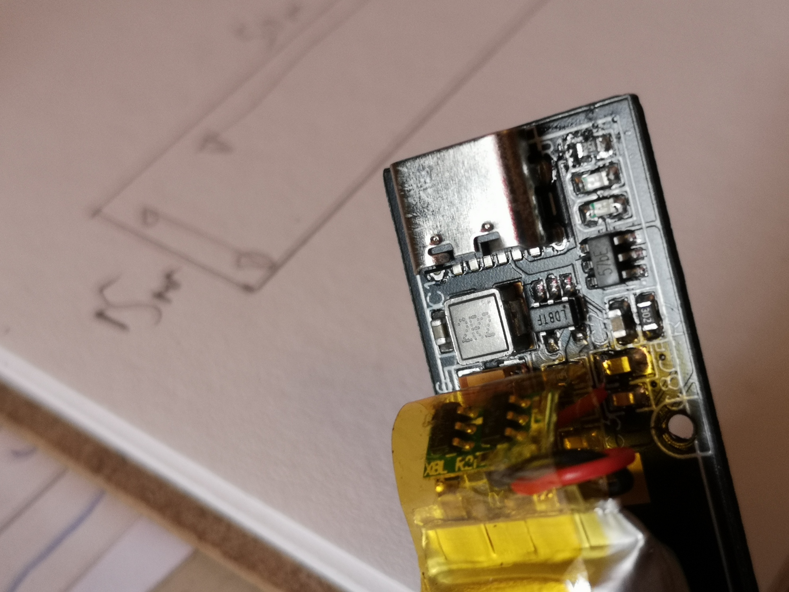
research/upload_2023-10-1_13-9-23.jpeg
