donnels/aiwa-pb-3/results/cad/pb3-fit-check.stl

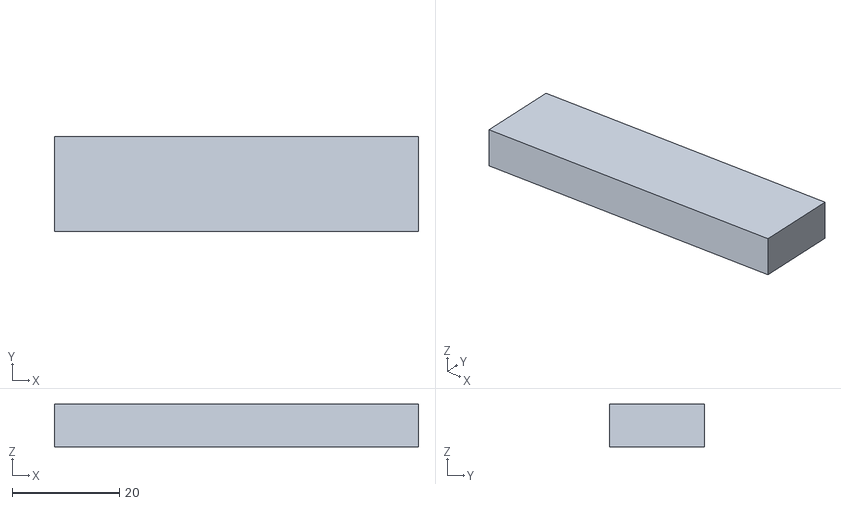
[picture p21: CAD file, 2026-09-06]
results/cad/pb3-fit-check.stl
68.0 x 17.8 x 8.00
