donnels/aiwa-pb-3/results/kicad/pb3-replacement.step

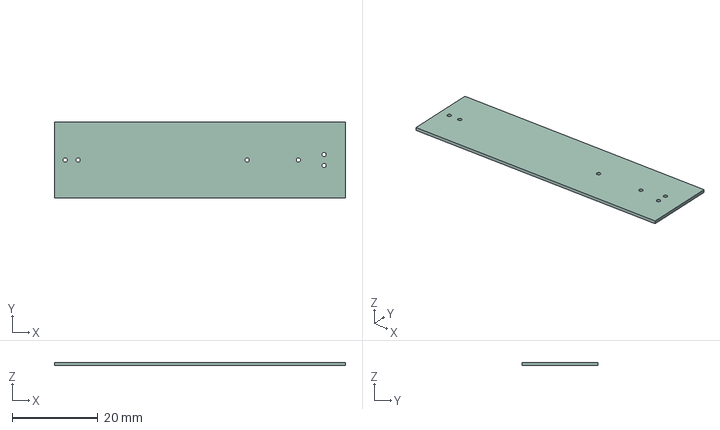
[picture p22: CAD file, 2026-09-06]
results/kicad/pb3-replacement.step
68.0 x 17.8 x 0.73 mm
