donnels/aiwa-pb-3/results/cad/pb3-pack.stl

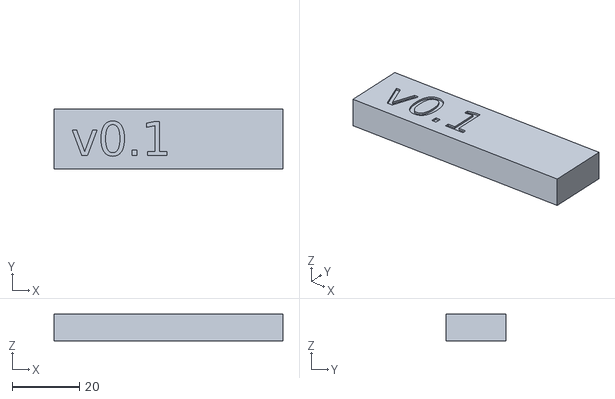
[picture p23: CAD file, 2025-12-11]
results/cad/pb3-pack.stl
68.0 x 17.8 x 8.00
