donnels/aiwa-pb-3/(list of files, cad)

Other CAD files:
results/cad/pb3-replacement-board.stl
