donnels/aiwa-pb-3/results/README.adoc

= Results & Compliance
ifndef::flag-book[]
:toc: right
:toclevels: 5
:sectnums:
:sectnumlevels: 5
endif::[]
ifdef::flag-book[]
:imagesdir-save: {imagesdir}
:imagesdir: results
endif::[]

This directory contains outputs generated by the containerized CAD and
simulation workflow. Do not edit these files by hand — they are evidence
that the design in `openscad/`, `kicad/`, and `images/` meets the two
targets set in the research and reverse-engineering steps: fitting the
original 68×17.8×8mm envelope, and delivering a safe, regulated 2.0V rail.

* `cad/` — OpenSCAD renders.
* `diagrams/` — PlantUML circuit and architecture diagrams.
* `kicad/` — KiCad board previews, schematic exports, and fabrication files.
* `circuit/` — ngspice logs and measurements.
* `docs/` — assembled HTML and PDF documentation (this book).

Rebuild everything with the `Build` GitHub Actions workflow, or run the
container commands in `.github/workflows/build.yml` locally.

== Physical Compliance

.`pb3-pack` fit-check render


`cad/pb3-pack.stl` is the printable gauge block for the 68×17.8×8mm
outline and 52×15×6mm cell cavity measured in `measurements/README.adoc`.
A print that fits the original PB-3 bay confirms the mechanical envelope
before any PCB is fabricated. `kicad/pb3-replacement-board.svg` and the
`kicad/fabrication/` gerbers/drill/position files are what a fabricator
needs to build the board that has to fit inside that same envelope.

.`pb3-fit-check` render: real board (green) inside the measured envelope (transparent)
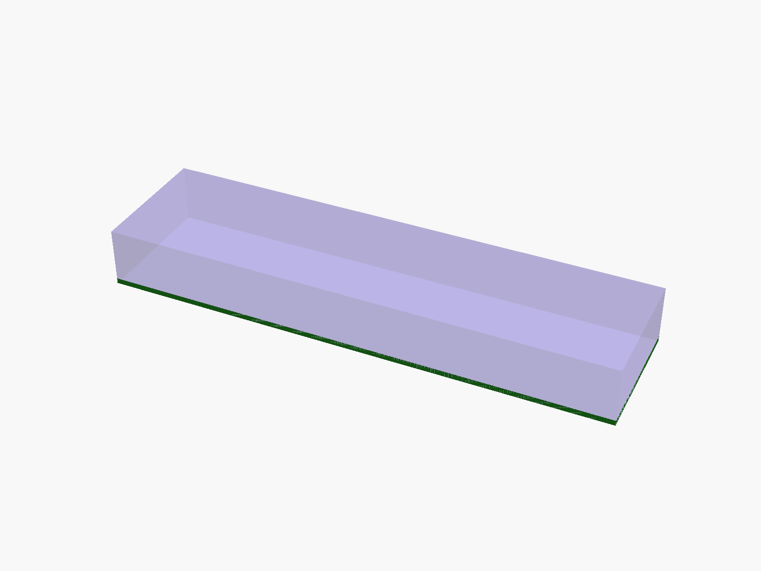
[picture p24: results/cad/pb3-fit-check.png]


`cad/pb3-fit-check.stl` is the digital counterpart to the `pb3-pack`
print test: `cad/pb3-replacement-board.stl` (converted from
`kicad/pb3-replacement.glb`, see "Circuit Design & Emulation") is
imported into the same envelope model. The board fitting entirely
inside the transparent walls confirms the KiCad layout matches the
physically-verified envelope.

`kicad/pb3-replacement.step` and `.glb` are the raw 3D exports of the
board, usable in any MCAD/3D tool. `kicad/pb3-replacement-render-top.png`
and `-render-iso.png` are photorealistic renders of the finished board.

== Electrical Compliance

`circuit/pb3-architecture-sizing.log` is the ngspice run of Stage 1
(architecture sizing) of the circuit emulation described in the "Circuit
Design & Emulation" step — see that step for the expected pass values
and for why Stage 1 alone is not a verification of the real schematic.
`kicad/pb3-replacement-schematic.pdf` and `-schematic.svg` are the
schematic exports of the same design.

== Toolchain Proof

`kicad/batteryPack-schematic.pdf`, `batteryPack-pcb-top.svg`, and
`batteryPack-pcb-bottom.svg` are the outputs of the "KiCad Hello World"
toolchain check: the same KiCad → KiBot → CI pipeline used above, proven
on a known-good sample project first.

== Free Training & Docs

* https://docs.github.com/en/actions[GitHub Actions documentation] — the
  workflow that renders and commits everything in this directory.
* https://github.com/sdras/awesome-actions[awesome-actions] — curated
  list of free GitHub Actions building blocks, for anyone adapting this
  container-based render pipeline.

//END OF DOC
ifdef::flag-book[]
:imagesdir: {imagesdir-save}
endif::[]
