donnels/aiwa-pb-3/measurements/README.adoc

= Measuring the PB-3 and context
ifndef::flag-book[]
:toc: right
:toclevels: 5
:sectnums:
:sectnumlevels: 5
endif::[]
ifdef::flag-book[]
:imagesdir-save: {imagesdir}
:imagesdir: measurements
endif::[]

This directory holds every measurement photo, caliper log, and derived dimension used to build the PB-3 models.

== Measurement Photos

=== Original PB-3 SLA pack
==== Width [67.73, 67.75]
.Width calipered underside (67.73mm)
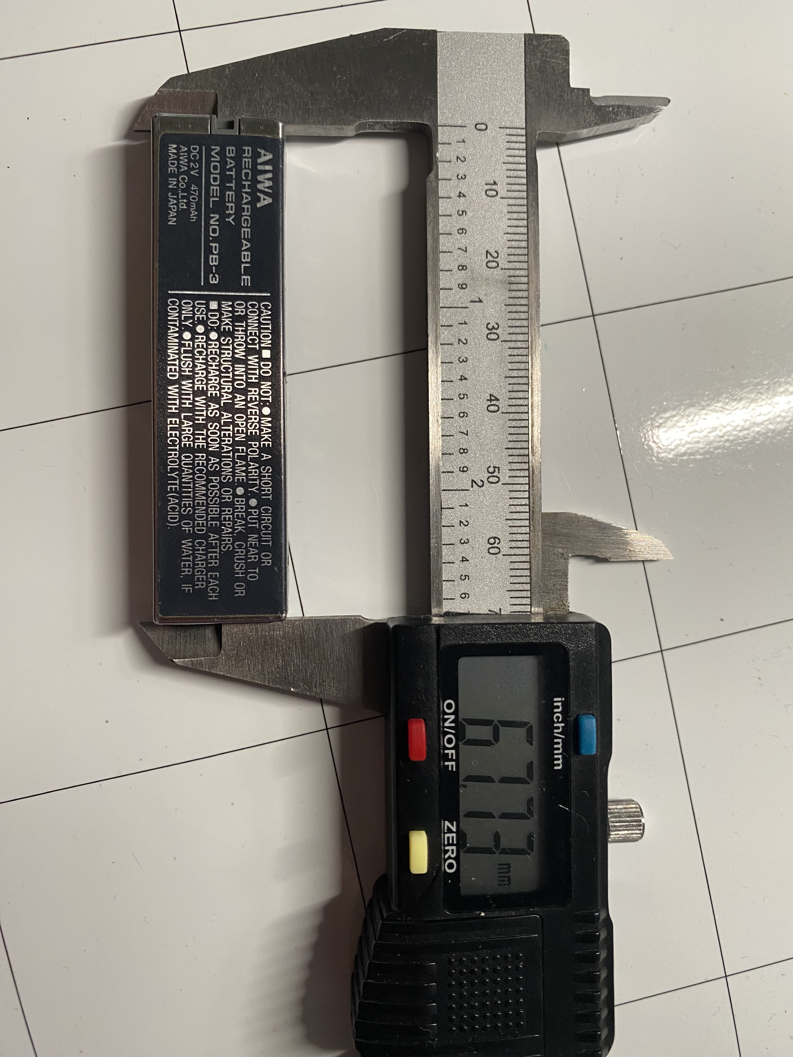
[picture p25: measurements/IMG_9373.jpeg]


.Width calipered top (67.75mm)
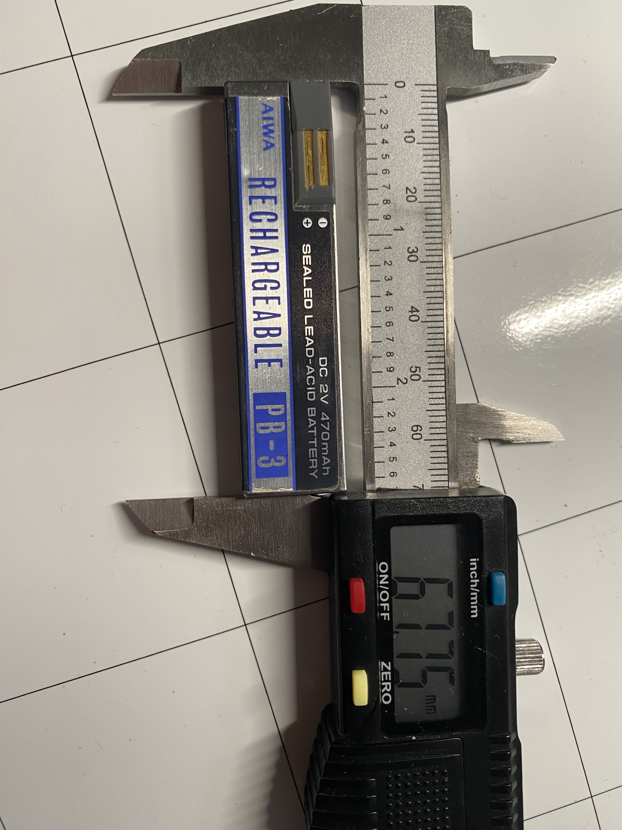
[picture p26: measurements/IMG_9374.jpeg]


==== Height [8.19, 8.12]
.Height calipered side (8.19mm)
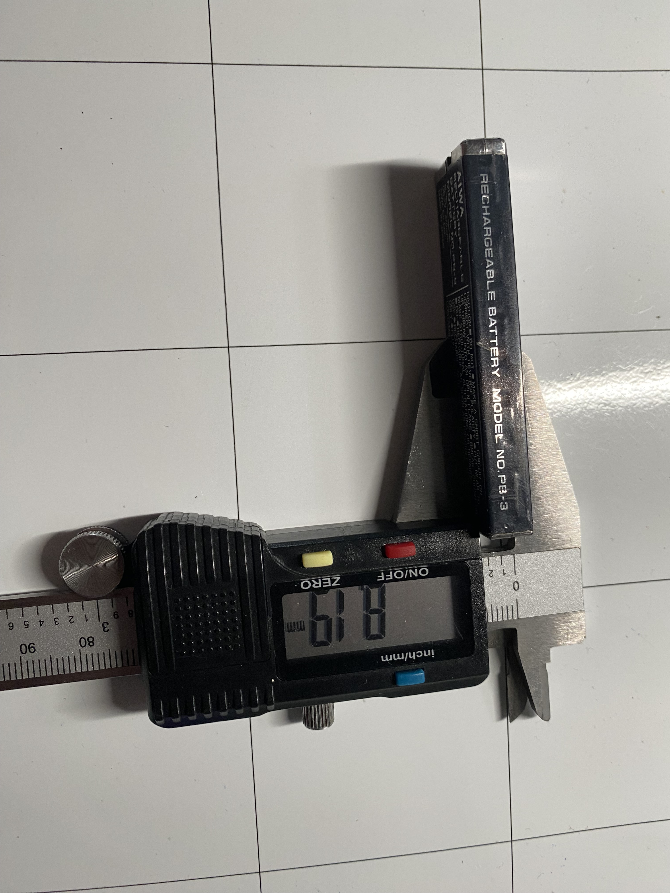
[picture p27: measurements/IMG_9375.jpeg]


.Height calipered side (8.12mm)
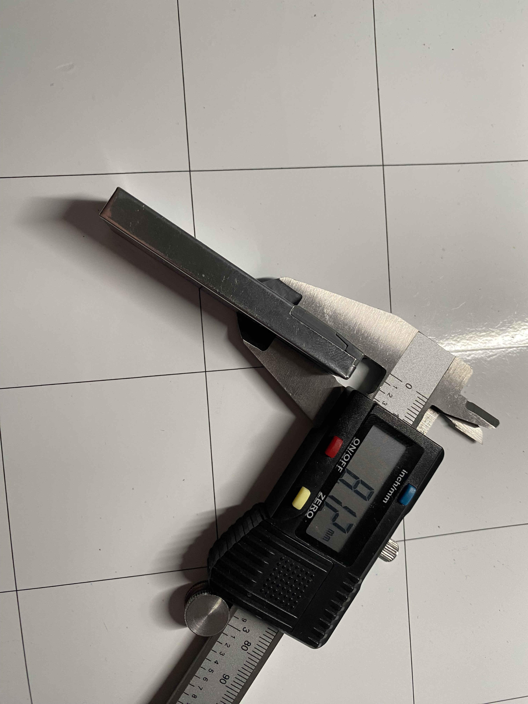
[picture p28: measurements/IMG_9378.jpeg]


==== Depth [17.65, 17.55]
.Depth calipered top (17.65mm)
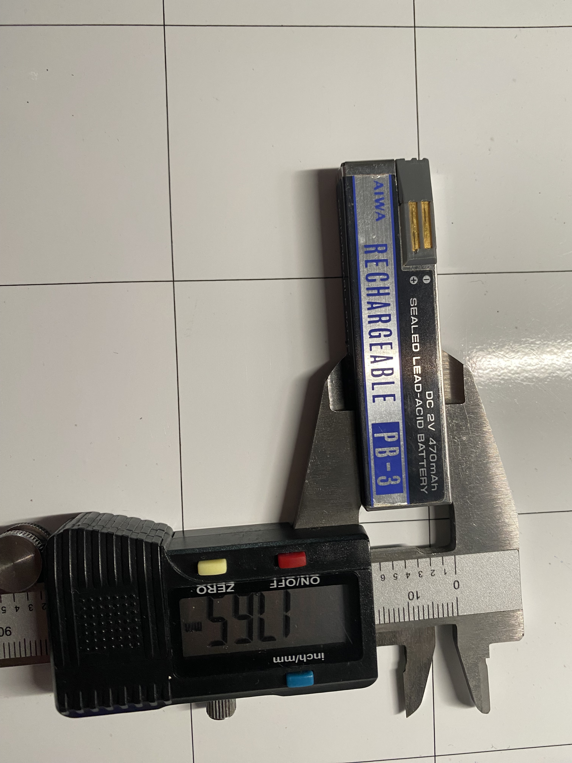
[picture p29: measurements/IMG_9376.jpeg]


.Depth calipered top (17.55mm)
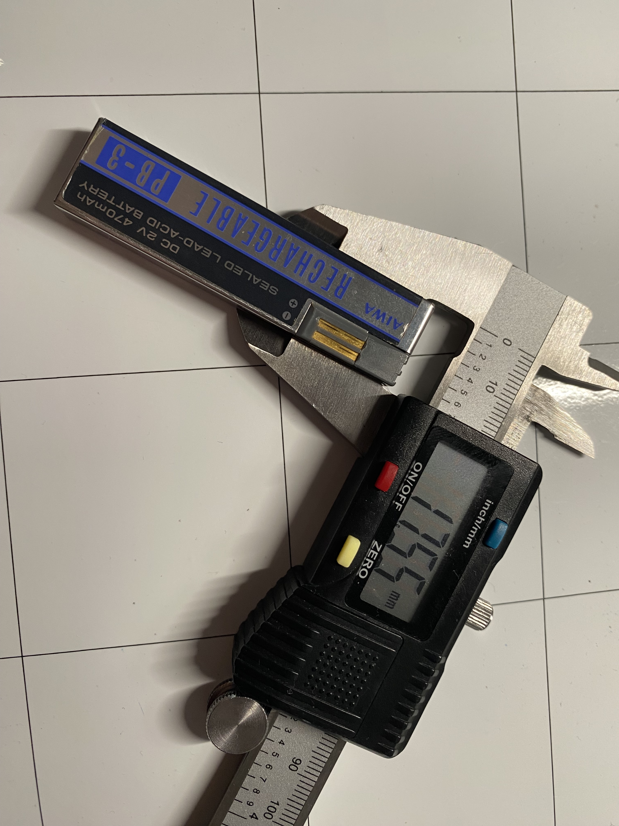
[picture p30: measurements/IMG_9377.jpeg]


=== Battery holder

.battery holder Depth
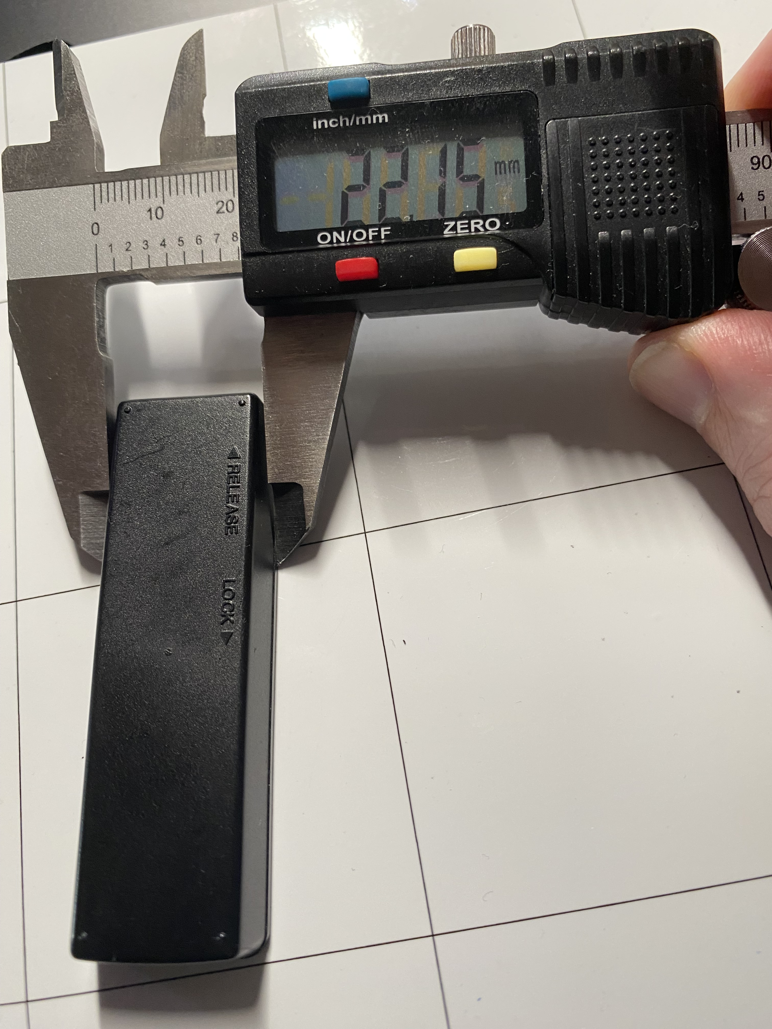
[picture p31: measurements/IMG_9379.jpeg]


.battery holder Width
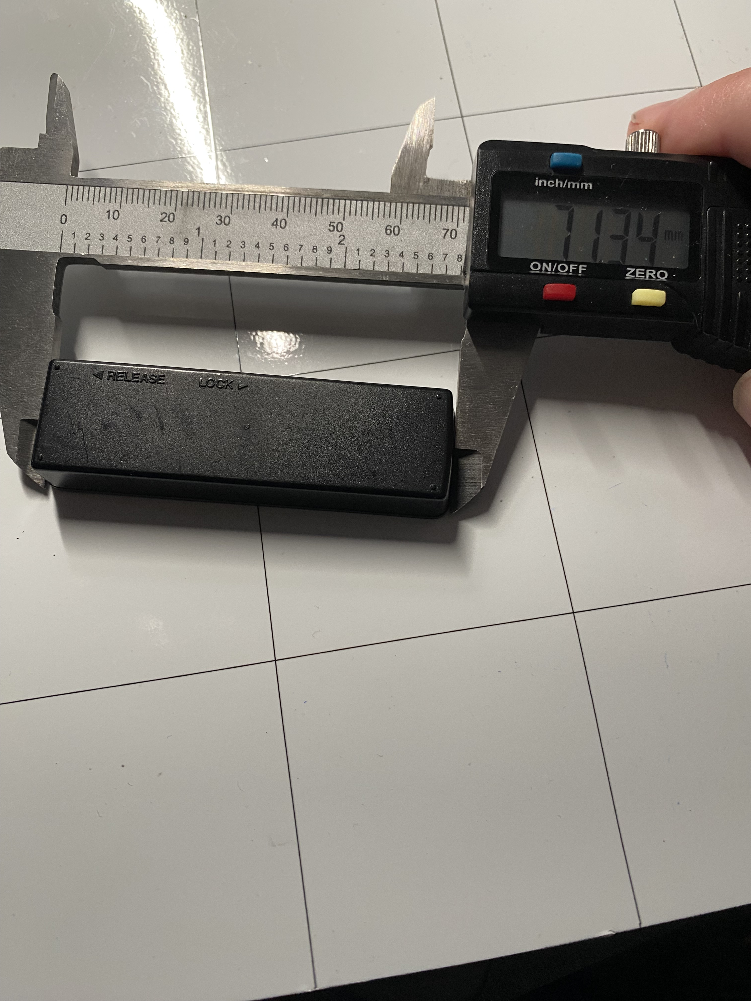
[picture p32: measurements/IMG_9380.jpeg]


.battery holder Height
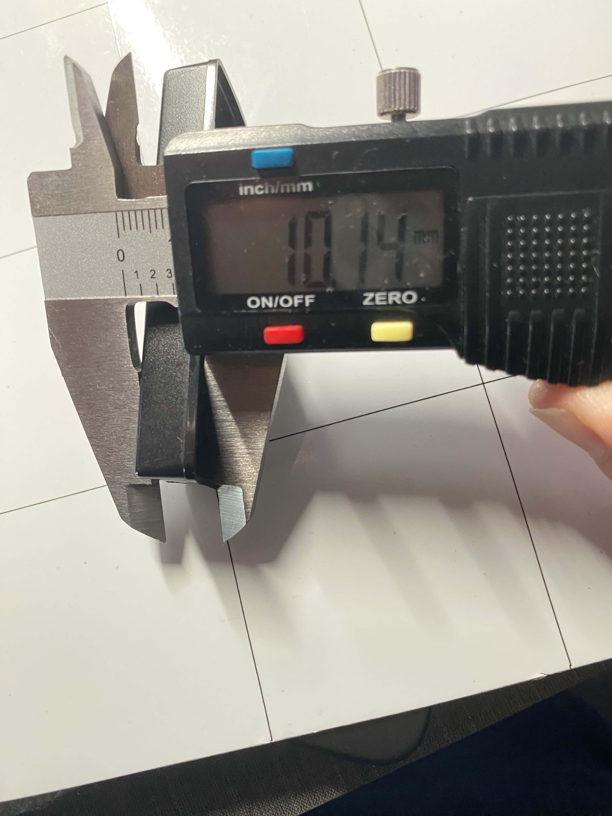
[picture p33: measurements/IMG_9381.jpeg]


.battery holder inside view
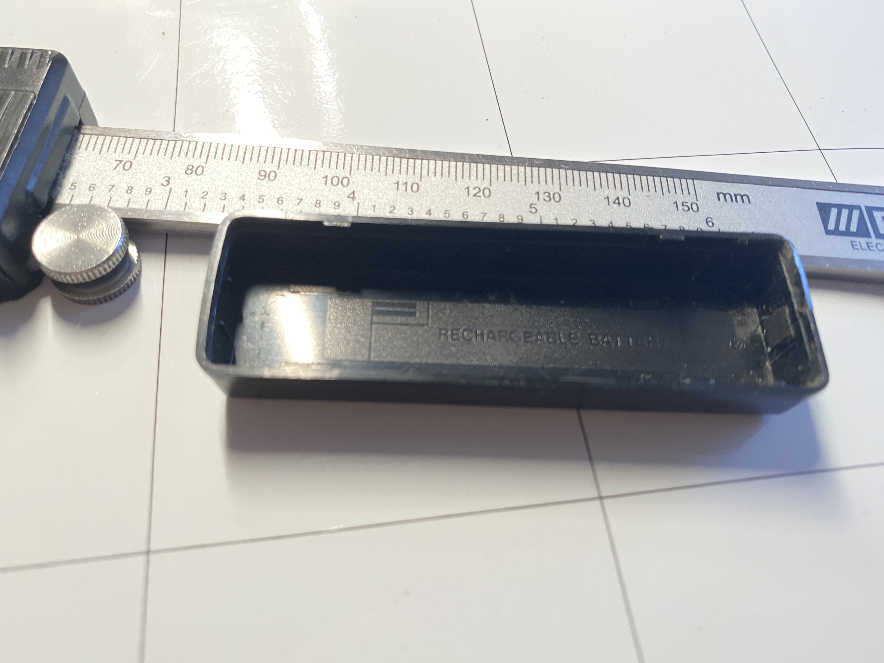
[picture p34: measurements/IMG_9382.jpeg]


.battery holder inside view
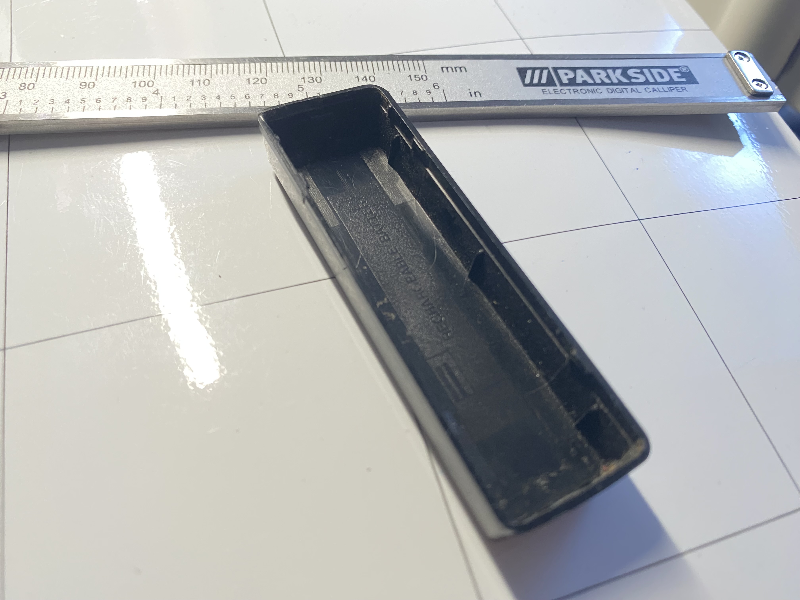
[picture p35: measurements/IMG_9383.jpeg]


.battery holder inside view
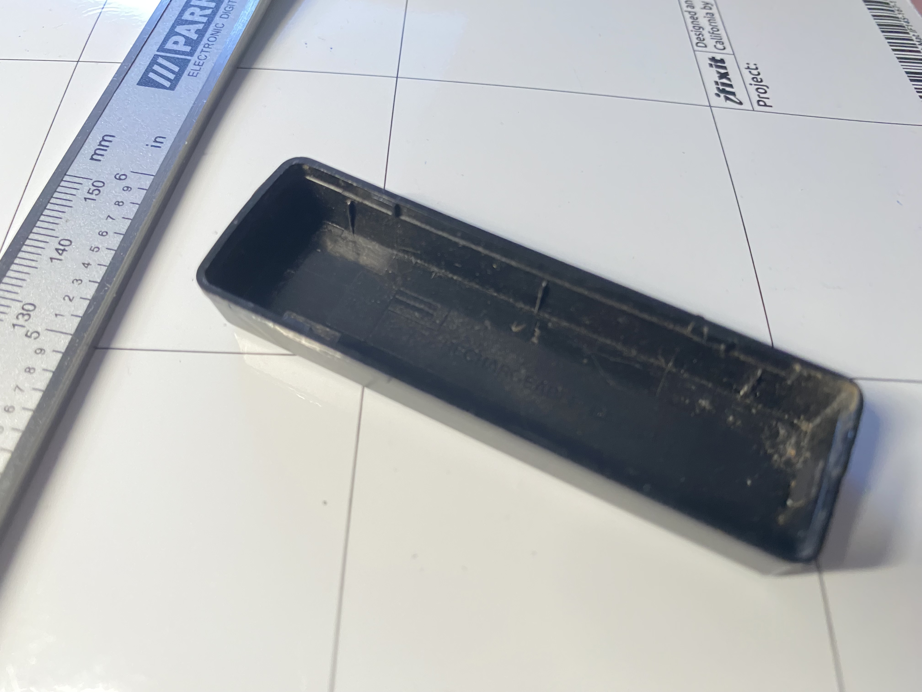
[picture p36: measurements/IMG_9384.jpeg]


.battery holder inside view
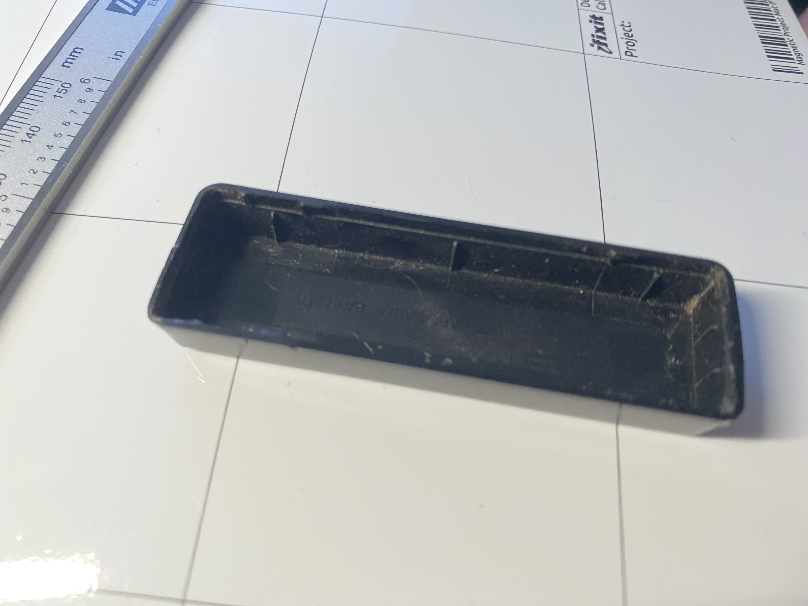
[picture p37: measurements/IMG_9385.jpeg]


== Free Training & Docs

* https://github.com/ad-si/awesome-3d-printing[awesome-3d-printing] —
  curated list of free 3D-printing tools and guides, including the print
  tolerance/calibration references used to trust these caliper
  measurements against a printed test fit.

//END OF DOC
ifdef::flag-book[]
:imagesdir: {imagesdir-save}
endif::[]
