donnels/aiwa-pb-3/results/docs/README.html

# aiwa pb-3 battery replacement

Table of Contents

- 1. Specs
- 2. Safety
- 3. How This Book Is Built
- 4. Step 1: Research
  - 4.1. Research
    - 4.1.1. Primary Source
    - 4.1.2. Original PB-3 Pack
    - 4.1.3. PB-S5 Clone Board (LAOWANG_DIY)
    - 4.1.4. Component Datasheets
    - 4.1.5. What This Enabled
    - 4.1.6. Free Training & Docs
- 5. Step 2: Measurements
  - 5.1. Measuring the PB-3 and context
    - 5.1.1. Measurement Photos
      - 5.1.1.1. Original PB-3 SLA pack
        - 5.1.1.1.1. Width [67.73, 67.75]
        - 5.1.1.1.2. Height [8.19, 8.12]
        - 5.1.1.1.3. Depth [17.65, 17.55]
      - 5.1.1.2. Battery holder
    - 5.1.2. Free Training & Docs
- 6. Step 3: Design Notebook
  - 6.1. PB-3 Reverse-Engineering Notebook
    - 6.1.1. Objective
    - 6.1.2. What is Known Today
    - 6.1.3. Research Findings
      - 6.1.3.1. Stereo2Go thread highlights
      - 6.1.3.2. Derived Requirements
    - 6.1.4. Host Deck Reality
    - 6.1.5. Research To-Do List
    - 6.1.6. Proposed Replacement Strategy
    - 6.1.7. Electrical Block Requirements
    - 6.1.8. Mechanical Considerations
    - 6.1.9. Living CAD + Automation
    - 6.1.10. Reverse-Engineering Workflow
    - 6.1.11. Future KiCad Artifacts
    - 6.1.12. Validation & Test Plan
    - 6.1.13. Open Questions
    - 6.1.14. Next Immediate Steps
    - 6.1.15. Free Training & Docs
- 7. Step 4: KiCad Hello World
  - 7.1. Battery Pack - KiCad Hello World
    - 7.1.1. Attribution
    - 7.1.2. Circuit
    - 7.1.3. Getting Started (Noobs/me)
      - 7.1.3.1. Install KiCad on Steam Deck
      - 7.1.3.2. Opening This Project
      - 7.1.3.3. What to Look Out For
      - 7.1.3.4. Learning Resources
    - 7.1.4. PCB
    - 7.1.5. Outputs
      - 7.1.5.1. Schematic
      - 7.1.5.2. PCB Top View
      - 7.1.5.3. PCB Bottom View
    - 7.1.6. Shit Happens: Troubleshooting CI/CD Setup
      - 7.1.6.1. GitHub raw URLs returning 404
      - 7.1.6.2. GitHub Pages deployment 404
      - 7.1.6.3. KiBot not generating gerbers/drill/position files
    - 7.1.7. References
      - 7.1.7.1. Minimal Examples
      - 7.1.7.2. Tutorials
    - 7.1.8. Free Training & Docs
- 8. Step 5: Mechanical Design (OpenSCAD)
  - 8.1. OpenSCAD Renders
    - 8.1.1. pb3-pack
    - 8.1.2. pb3-fit-check
    - 8.1.3. Free Training & Docs
- 9. Step 6: Circuit Design & Emulation (KiCad)
  - 9.1. Circuit Design & Emulation
    - 9.1.1. Component Selection
    - 9.1.2. Circuit Emulation
    - 9.1.3. PCB Routing
    - 9.1.4. 3D Exports & Renders
    - 9.1.5. Free Training & Docs
- 10. Step 7: Architecture Diagrams
  - 10.1. PlantUML Diagrams
    - 10.1.1. PB3Architecture
    - 10.1.2. Free Training & Docs
- 11. Step 8: Results & Compliance
  - 11.1. Results & Compliance
    - 11.1.1. Physical Compliance
    - 11.1.2. Electrical Compliance
    - 11.1.3. Toolchain Proof
    - 11.1.4. Free Training & Docs
- 12. Architecture Decisions
  - 12.1. Architecture Decision Records
    - 12.1.1. Philosophy
    - 12.1.2. What
    - 12.1.3. Why
    - 12.1.4. Format
    - 12.1.5. Index
      - 12.1.5.1. ADR-001: Commit Generated Artifacts Next to Source
        - 12.1.5.1.1. Context
        - 12.1.5.1.2. Decision
        - 12.1.5.1.3. Alternatives
        - 12.1.5.1.4. Implications
        - 12.1.5.1.5. Files Affected
      - 12.1.5.2. ADR-002: Use Text-Based CAD and Documentation Formats
        - 12.1.5.2.1. Context
        - 12.1.5.2.2. Decision
        - 12.1.5.2.3. Alternatives
        - 12.1.5.2.4. Implications
        - 12.1.5.2.5. Examples
        - 12.1.5.2.6. Tools Used
      - 12.1.5.3. ADR-003: Use GitHub Actions for All Build Automation
        - 12.1.5.3.1. Context
        - 12.1.5.3.2. Decision
        - 12.1.5.3.3. Alternatives
        - 12.1.5.3.4. Implications
        - 12.1.5.3.5. Why Not Magic
        - 12.1.5.3.6. Workflow Structure
        - 12.1.5.3.7. Traceability Example
        - 12.1.5.3.8. Living Documentation
        - 12.1.5.3.9. Tools vs Process
      - 12.1.5.4. ADR-004: File Extension Conventions for Main vs Include Files
        - 12.1.5.4.1. Context
        - 12.1.5.4.2. Decision
        - 12.1.5.4.3. Alternatives
        - 12.1.5.4.4. Implications
        - 12.1.5.4.5. Examples
        - 12.1.5.4.6. Directory Structure
        - 12.1.5.4.7. CI Impact
      - 12.1.5.5. ADR-005: Conditional imagesdir Management for Book Assembly
        - 12.1.5.5.1. Context
        - 12.1.5.5.2. Decision
        - 12.1.5.5.3. Alternatives
        - 12.1.5.5.4. Implications
        - 12.1.5.5.5. Pattern
        - 12.1.5.5.6. Files Using Pattern
        - 12.1.5.5.7. Why Save/Restore
      - 12.1.5.6. ADR-006: Single Job Render Pipeline
        - 12.1.5.6.1. Context
        - 12.1.5.6.2. Decision
        - 12.1.5.6.3. Alternatives
        - 12.1.5.6.4. Implications
        - 12.1.5.6.5. Why Not Jobs
        - 12.1.5.6.6. Pattern
    - 12.1.6. Free Training & Docs
- 13. Credits
- 14. Containerized builds

USB-C rechargeable LiPo replacement for the AIWA PB-3/PB-4 battery pack.

Note | This is a personal project, not affiliated with or endorsed by AIWA. This is my first outing with KICAD and PCB design; forgive stupidity and ignorance.

## 1. Specs

Parameter | Original PB-3 | This Design
Chemistry | Lead-acid | LiPo
Cell voltage | 2V | 3.7V nominal
Output voltage | 2V | 2.0V (adjustable 2.0-2.4V)
Capacity | 470mAh | 500-1500mAh
Charging | Proprietary | USB-C 5V

## 2. Safety

- Buck DC-DC steps 3.7V → 2.4V
- OVP (Zener/TVS) clamps output <3V if buck fails
- DW01A+FS8205A BMS: OV/UV/OC protection

## 3. How This Book Is Built

This README is a step-by-step training example: it walks from raw research to a working, physically- and electrically-compliant battery pack, including the toolchain checks done along the way. Every step below is its own README.adoc in its own directory, assembled here with include:: and leveloffset — nothing is a link, so the whole story reads top to bottom in one document.

1. Research — collect teardown photos, forum knowledge, and IC datasheets.
2. Measurements — caliper the original pack and derive the mechanical envelope.
3. Design Notebook — turn research and measurements into requirements.
4. KiCad Hello World — prove the KiCad → KiBot → CI toolchain on a known-good project.
5. Mechanical Design — OpenSCAD fit-check model of the envelope.
6. Circuit Design & Emulation — KiCad schematic, component selection, ngspice model.
7. Architecture Diagrams — PlantUML system diagrams.
8. Results & Compliance — generated evidence that the design fits and works.

## 4. Step 1: Research

### 4.1. Research

Before any CAD or schematic work started, this project collected evidence: teardown photos of the original PB-3, teardown photos of a working Aliexpress clone, a forum thread archive, and the datasheets for the candidate ICs. Everything downstream — measurements, mechanical envelope, component selection, circuit emulation — traces back to a file in this directory.

#### 4.1.1. Primary Source

- link:Rechargeable battery replacement for AIWA PB-3 _ PB-4 _ Stereo2Go forums.html[Stereo2Go forum thread] (offline archive) — "Rechargeable battery replacement for AIWA PB-3 / PB-4" (Rossoe et al., 2023-2025). Original: https://stereo2go.com/forums/threads/rechargeable-battery-replacement-for-aiwa-pb-3-pb-4.9025/. Source for the clone teardown photos, the LAOWANG_DIY PCB reference, the 100kΩ→120kΩ resistor mod for voltage selection, and community pricing/part numbers.

#### 4.1.2. Original PB-3 Pack

PB 3a

Figure 1. PB-3 label: DC 2V, 900mAh, Li-Polymer, rechargeable, two-pin blade

PB 3g

Figure 2. PB-3 case detail: USB-C port molded into a 3D-printed shell

The original pack’s own label already reveals the mismatch this project resolves: it is printed "2V 900mAh Li-Polymer" although the AIWA-branded factory part is a 2V sealed lead-acid (SLA) cell. The label documents the replacement’s chemistry and rating, not the OEM part. Additional angles and connector close-ups are archived as PB-3b.jpg–PB-3e.jpg and PB3-f.jpg.

#### 4.1.3. PB-S5 Clone Board (LAOWANG_DIY)

PB S5a

Figure 3. LAOWANG_DIY PCB with LiPo pouch cell attached, marked C7/C4 pads

The PB-S5 shares its PCB with the PB-3 clone. Teardown photos (PB-S5b.jpg–PB-S5k.jpg) show the flat LiPo pouch bonded directly to the board, the charger/protection/buck ICs in SOT-23-6 packages, and the feedback resistor referenced in the forum thread’s voltage-selection mod. upload_2023-10-1_13-9-23.jpeg is an additional forum upload showing the assembled clone pack next to a host deck.

#### 4.1.4. Component Datasheets

Three IC families recur across the clone teardowns and this project’s own design in kicad/README.adoc. Each datasheet is archived here so the component choice can be checked against real electrical limits instead of guesswork.

CN3058E — LiPo linear charger

1811141710_Consonance-Elec-CN3058E_C83278.pdf. Single-cell Li-ion/LiPo linear charge management IC, SOT-23-6. Takes 5V USB-C input, delivers CC/CV charging to the cell, and is the kind of part visible on the clone PCB feeding the pouch cell in PB-S5a.jpg. Selected for its small footprint and simple external component count (a handful of passives), matching the tight 68×17.8×8mm enclosure.

DW01x — battery protection IC

DW01x-DS-17_EN.pdf. Pairs with a dual N-MOSFET (e.g. FS8205A) to form a discrete battery management system: overvoltage, undervoltage, and overcurrent/short-circuit cutoff on the cell tabs. Chosen over relying on the charger IC alone, so the pack still fails safe if the charger or buck stage misbehaves.

TPS61023 — DC-DC regulator

tps61023.pdf. SOT-23-6 DC-DC IC used to regulate the raw ~3.7V cell rail down to the 2.0–2.4V the deck expects, with the feedback resistor pair setting the output voltage — a higher resistor lowers the output. The forum thread’s own swap goes 100kΩ (PB-S5 clone’s 2.4V default) to 120kΩ (2.1V); reaching this project’s 2.0V target extrapolates to a resistor above 120kΩ. Its behavioral model stands in for the buck stage in kicad/pb3-replacement.cir, described in the circuit design and emulation step.

#### 4.1.5. What This Enabled

- measurements/README.adoc — caliper measurements of the original pack and the clone’s cavity, confirming the 68×17.8×8mm envelope.
- pb3-notes.adoc — the reverse-engineering notebook that turns the above into derived requirements (chemistry, capacity target, connector compatibility, fault protection).
- kicad/README.adoc — schematic component selection and circuit emulation built on the ICs identified here.

#### 4.1.6. Free Training & Docs

- Stereo2Go forum thread (https://stereo2go.com/forums/threads/rechargeable-battery-replacement-for-aiwa-pb-3-pb-4.9025/) — the original community teardown and battery-replacement research this project builds on.
- awesome-electronics (https://github.com/kitspace/awesome-electronics) — curated list of free datasheets, application notes, and component references for reading the ICs cited above.

## 5. Step 2: Measurements

### 5.1. Measuring the PB-3 and context

This directory holds every measurement photo, caliper log, and derived dimension used to build the PB-3 models.

#### 5.1.1. Measurement Photos

##### 5.1.1.1. Original PB-3 SLA pack

###### 5.1.1.1.1. Width [67.73, 67.75]



Figure 4. Width calipered underside (67.73mm)



Figure 5. Width calipered top (67.75mm)

###### 5.1.1.1.2. Height [8.19, 8.12]



Figure 6. Height calipered side (8.19mm)



Figure 7. Height calipered side (8.12mm)

###### 5.1.1.1.3. Depth [17.65, 17.55]



Figure 8. Depth calipered top (17.65mm)



Figure 9. Depth calipered top (17.55mm)

##### 5.1.1.2. Battery holder



Figure 10. battery holder Depth



Figure 11. battery holder Width



Figure 12. battery holder Height



Figure 13. battery holder inside view



Figure 14. battery holder inside view



Figure 15. battery holder inside view



Figure 16. battery holder inside view

#### 5.1.2. Free Training & Docs

- awesome-3d-printing (https://github.com/ad-si/awesome-3d-printing) — curated list of free 3D-printing tools and guides, including the print tolerance/calibration references used to trust these caliper measurements against a printed test fit.

## 6. Step 3: Design Notebook

### 6.1. PB-3 Reverse-Engineering Notebook

#### 6.1.1. Objective

Build a present-day PB-3 pack that wakes an AIWA HS-PC202MII. That deck is the primary test bed and end user. The wall wart is missing, the stock SLA is dead, and donor packs only exist as forum photos, so every measurement and assumption comes from images plus clone teardowns.

#### 6.1.2. What is Known Today

Topic | Details | Confidence
Mechanical envelope | Caliper photos show 68 mm × 17.8 mm × 8 mm overall and a 52 mm × 15 mm × 6 mm cell bay. Thin plastic shell, PCB island at the connector end with fuse and ballast resistor.[1] | High. Need one more sample to average tolerance.
Electrical interface | Two-pin keyed blade plus PB-4 top pads. Clone pack shows 3.67 V LiPo feeding a converter that outputs 2.41 V on the blades; wiring solders directly to the IC pins.[s2g] HS-PC202MII schematic is unavailable, so reverse engineering relies on photos and continuity tests once the clone arrives. | Low. Need deck-side schematic to confirm charge routine and pinout.
Chemistry and capacity | Original PB-3 spec sheet rated 470 mAh SLA. Community teardowns hint at 700–800 mAh service packs, but clones today ship 500 mAh LiPo with buck down to 2.4 V.[s2g] | Medium. Need an unopened OEM cell for proof.
Community precedents | Baidu and Stereo2Go builds use 3D-printed shells plus Li-ion or LiPo stages, usually without fault clamps or plated blades.[s2g] | High. Reuse photos only with permission.

#### 6.1.3. Research Findings

##### 6.1.3.1. Stereo2Go thread highlights

- AliExpress PB-3/PB-4 USB-C pack runs £14, lists 900 mAh, hides 500 mAh LiPo, spits 3.67 V raw and 2.41 V at the blades.[2]
- Shell size is 68 mm × 17.8 mm × 8 mm. Battery cavity maxes at 52 mm × 15 mm × 6 mm, so 500 mAh is the ceiling until cells improve.[2]
- 3D printed case flexes, screw bosses die fast, only top contacts get plating.[2]
- Pack leads land right on converter pins. Bare copper hovers over inductors. No strain relief.[2]
- If the buck converter fails, the deck eats the full 3.7 V. Need a clamp or crowbar that kills the fault.[2]
- PB-S5 board is the same. Swap the marked 100 kΩ resistor for 120 kΩ to hit 2.1 V. 0603 footprint.[2]
- Search phrase "500mAh lipo battery 6mm" finds cells that fit; nothing larger ships yet.[2]
- Wickedkraft sells a pricier variant on eBay. No autopsy yet but likely the same guts.[2]

##### 6.1.3.2. Derived Requirements

- USB-C charging. Retire the fragile Aiwa wall wart.[2]
- Runtime must beat the 470 mAh SLA. Target >900 mAh effective at 2V output.[2]
- Respect 68 mm × 17.8 mm × 8 mm overall and 52 mm × 15 mm × 6 mm cell cavity. Keep PB-4 top contacts alive.[2]
- Plate every blade. Reinforce the connector window so owners stop snapping plastic.[2]
- Terminate the cell on pads with relief. No bare wires surfing active parts.[2]
- Add a fault clamp so output never drifts past 2.4 V even if the buck fails. Make PB-S5 vs PB-3 voltage a resistor change.[2]

#### 6.1.4. Host Deck Reality

- Runner: AIWA HS-PC202MII. This deck will see every prototype first and is the reason the project exists.
- Constraints: OEM wall wart is missing, OEM PB-3 pack is dead, and voltage measurements of it are not relevant (0v). Reverse engineering starts with images of clone PCBs.

#### 6.1.5. Research To-Do List

1. Imagery: pull clean teardown photos from Baidu Tieba (随身听 PB-3) and Japanese blogs. Capture rulers or redraw.
2. Connector survey: borrow a PB-3 pack or host deck. Log pitch, depth, retention, plating.
3. Power sweep: record float voltage, discharge curve, deck charge current while the donor SLA still lives (if there is one which there isn’t).
4. Archive: dump every measurement, photo, and trace into this repo before CAD starts.

#### 6.1.6. Proposed Replacement Strategy

SLA is dead weight. Teardown of Aliexpress clone confirms the working approach.

LiPo 1S (3.7V nominal) + buck to 2.0V

+ Matches existing clone design (LAOWANG_DIY board) + 500mAh cell → 900mAh effective at 2V output + Buck topology (step-down) matches 3.7V→2.0V requirement + BMS often on cell flex PCB

Baseline design: 1S LiPo 500mAh + buck converter regulated at 2.0V matching the original PB-3 output.

#### 6.1.7. Electrical Block Requirements

- Cell: 500mAh LiPo pouch, ~6mm thick, matches 52×15×6mm cavity
- BMS: On cell flex PCB (clone) or discrete DW01A+FS8205 (our design)
- Buck: SOT-23-6 IC, 2.2µH inductor, configured for 2.0V output
- Rfb: 100k = 2.4V, 120k = 2.1V (per Stereo2Go mod). Adjust for 2.0V target.
- Charge path: USB-C 5V → charger IC (SOT-23-6) → CC/CV 4.2V to cell
- OVP: Zener/TVS clamp <3V to protect deck if buck fails (improvement over clone)

#### 6.1.8. Mechanical Considerations

- Stay inside the original outline so the bay latch still works. 0.8 mm FR-4 maximizes cell room.
- Scan or caliper a donor shell. Build a STEP model for interference checks.
- Reuse the original keyed blade if possible. If not, design a flex tail or custom edge connector footprint.
- Rough CAD now lives in openscad/pb3-pack.scad (OpenSCAD). Dimensions trace back to measurements/IMG_9373.jpeg–IMG_9385.jpeg plus the Stereo2Go thread captured in research/.

First Solid CAD Model

// PB-3 battery pack simplification: single solid block matching the outer
// envelope, embossed with a version marker. See include-pb3-envelope.scad
// for the shared dimensions (also used by pb3-fit-check.scad).
include <include-pb3-envelope.scad>

pb3_envelope(emboss_version=true);
// To test fitting, run OpenSCAD and export to STL. Then 3D print a test block to verify fit in the PB-3 housing.

pb3 pack

Figure 17. output image

#### 6.1.9. Living CAD + Automation

- openscad/pb3-pack.scad is the print gauge. Version is embossed on the block so prints always tell you which assumption set they follow.
- kicad/pb3-replacement.kicad_pro (plus .kicad_sch/.kicad_pcb) tracks the electrical build. It is tagged V0.1 in the title blocks so KiCad exports line up with the physical gauges.
- .github/workflows/cad-build.yml is the single entry workflow. Jobs: openscad, plantuml, kicad → publish which copies artifacts into docs/generated/ and commits.

#### 6.1.10. Reverse-Engineering Workflow

1. De-pot a PB-3 with heat and patience. Photograph each layer.
2. Trace the PCB. Mark every component, resistor, and fuse.
3. Recreate the old schematic in KiCad. Understand what the deck expects before changing it.
4. Map new requirements against the host behavior.
5. Draft hierarchical KiCad sheets: Cell+BMS, Buck, Connector/NTC. Assign refs early.

#### 6.1.11. Future KiCad Artifacts

- kicad/pb3-replacement.kicad_pro — full project.
- mechanical/pb3-shell.step — shell model for fit checks.
- library/connector_aiwa_pb3.kicad_mod — blade footprint.

#### 6.1.12. Validation & Test Plan

Functional * Charge through USB-C. Log voltage and current curves. * Run a hungry deck like HS-PX505. Verify buck holds 2.0V ±0.1V during FF/REW. * Measure output with multimeter: target 2.0V (orig PB-3) or 2.4V (clone default).

Safety * Bake at 40 °C ambient. Keep silicon <85 °C. * Trip short-circuit protection under 20 ms.

Documentation * Export schematic PDFs and BOM straight from KiCad. * Keep PlantUML diagrams in images/ so architecture matches the board.

#### 6.1.13. Open Questions

- Do any decks sniff a third pin? Need proof before adding logic.
- Does the host trickle charge while on AC? Impacts design.
- Did Aiwa rely on SLA resistance rise for end-of-life? Might need a small gauge IC to mimic it.

#### 6.1.14. Next Immediate Steps

1. Source a PB-3 donor for teardown.
2. Measure connector plating and friction.
3. Spin initial KiCad sheets with placeholders.
4. Prototype the buck on eval hardware and log noise against the audio path.

#### 6.1.15. Free Training & Docs

- MADR — Markdown Architectural Decision Records (https://github.com/adr/madr) — the format this notebook’s decisions loosely follow, free and GitHub-hosted.
- awesome-electronics (https://github.com/kitspace/awesome-electronics) — same curated datasheet/reference list cited from the Research step, useful when re-checking an open question against a component datasheet.

## 7. Step 4: KiCad Hello World

### 7.1. Battery Pack - KiCad Hello World

Sean Donnellan :description: Complete battery circuit example for CI/CD pipeline testing :data-uri:

This is the toolchain’s "hello world": before designing the real PB-3 replacement, this project first proved KiCad + KiBot + CI could take a schematic to gerbers automatically, using a known-good sample project instead of an unfinished design. It uses the batteryPack example from KiBot’s test suite (https://github.com/INTI-CMNB/KiBot). It’s a complete, tested project that demonstrates KiBot automation with a real battery charging circuit.

#### 7.1.1. Attribution

Based on batteryPack example from KiBot test samples (https://github.com/INTI-CMNB/KiBot/tree/main/tests/board_samples/kicad_8).

Copyright (c) 2020-2024 Salvador E. Tropea
Copyright (c) 2020-2024 Instituto Nacional de Tecnología Industrial
License: AGPL-3.0

#### 7.1.2. Circuit

Battery management system with:

- Battery connector
- Charging circuit
- Power management components
- Protection circuitry

#### 7.1.3. Getting Started (Noobs/me)

##### 7.1.3.1. Install KiCad on Steam Deck

flatpak install flathub org.kicad.KiCad

Launch: Application Menu → Science&Math → KiCad

##### 7.1.3.2. Opening This Project

1. Launch KiCad
2. File → Open Project
3. Navigate to: ~/Documents/Github/donnels/aiwa-pb-3/kicad-hello-world/
4. Select: batteryPack.kicad_pro

##### 7.1.3.3. What to Look Out For

Steam Deck quirks (what I’m testing this on):

- Small screen
  - Use Ctrl + / Ctrl - to zoom schematic/PCB
  - OR use external monitor
- Save often
  - KiCad doesn’t auto-save. Ctrl+S is your friend.
- File paths
  - Flatpak sandboxes to ~/Documents. Keep projects there.
- Performance
  - PCB editor sluggish? Close other apps. Deck has 16GB RAM but KiCad uses chunks.

##### 7.1.3.4. Learning Resources

Video tutorials (watch before editing):

- Getting Started with KiCad 8 - DigiKey (https://www.youtube.com/watch?v=vaCVh2SAZY4) (30min) - Start here
- KiCad 6 STM32 Beginner Tutorial (https://www.youtube.com/watch?v=5fvdxd0QhTw) - Component placement, routing basics
- Shine On You Crazy KiCad (https://www.contextualelectronics.com/courses/shine-on-you-crazy-kicad/) - Chris Gammell’s free course (in-depth)

Official docs:

- KiCad Getting Started Guide (https://docs.kicad.org/8.0/en/getting_started_in_kicad/getting_started_in_kicad.html)

Quick tips:

- Schematic
  - Press A to add component, W to wire, M to move
- PCB
  - Press X to route track, V to add via, D to drag
- Hotkeys
  - Tools → Edit Hotkeys - memorize these or you’ll hate life

#### 7.1.4. PCB

Multi-layer board with battery charging components.

See the KiCad files for full details.

#### 7.1.5. Outputs

Expected to be generated by KiBot:

- batteryPack-schematic.pdf - Schematic
- batteryPack-schematic.svg - Schematic (SVG)
- batteryPack-pcb-top.svg - PCB top view
- batteryPack-pcb-bottom.svg - PCB bottom view
- gerbers/ - Manufacturing files

##### 7.1.5.1. Schematic

Schematic

Figure 18. Schematic (IF generated by KiBot)

##### 7.1.5.2. PCB Top View

PCB Top

Figure 19. PCB Top View (IF generated by KiBot)

##### 7.1.5.3. PCB Bottom View

PCB Bottom

Figure 20. PCB Bottom View (IF generated by KiBot)

#### 7.1.6. Shit Happens: Troubleshooting CI/CD Setup

##### 7.1.6.1. GitHub raw URLs returning 404

Problem: Tried downloading KiBot test samples via curl from raw.githubusercontent.com - all returned 14-byte "404: Not Found" HTML pages instead of actual KiCad files.

decided to dodge the bullet and just git clone the repo.

cd /tmp
git clone --depth 1 --filter=blob:none --sparse https://github.com/INTI-CMNB/KiBot.git
cd KiBot
git sparse-checkout set tests/board_samples/kicad_8
cp tests/board_samples/kicad_8/batteryPack.kicad_* /path/to/project/

This worked. Got real files.

##### 7.1.6.2. GitHub Pages deployment 404

Problem: actions/deploy-pages@v4 failed with 404:

Error: Creating Pages deployment failed
Error: HttpError: Not Found

Root cause: GitHub Pages not enabled for repo.

Solution: 1. Go to https://github.com/donnels/aiwa-pb-3/settings/pages 2. Source: GitHub Actions (NOT "Deploy from a branch") 3. Save

The workflow uses actions/upload-pages-artifact@v3 + actions/deploy-pages@v4 which deploy artifacts, not branches.

##### 7.1.6.3. KiBot not generating gerbers/drill/position files

Problem: kibot.yaml defines gerber, excellon, and position outputs but KiBot only generated first 5 outputs (schematic PDF/SVG, PCB top/bottom SVG). No gerbers, drill files, or position files in output.

Investigation:

find . -name "*.gbr" -o -name "*.drl" -o -name "*.pos"
# Returns nothing

Root cause: KiBot command didn’t explicitly request all outputs. May have stopped after warnings or first batch.

Solution: Add -s all flag to build.yml:

docker run --rm -v "$PWD":/w -w "/w/$dir" "$IMG_KICAD" \
  kibot -c kibot.yaml -s all

This explicitly requests all defined outputs instead of default subset.

#### 7.1.7. References

##### 7.1.7.1. Minimal Examples

- KiBot batteryPack Example (https://github.com/INTI-CMNB/KiBot/tree/main/docs/samples/Consolidate_PCBs) - Complete battery circuit with charger, tested with KiBot automation
- KiBot Test Samples (https://github.com/INTI-CMNB/KiBot/tree/main/tests/board_samples) - Collection of minimal boards for KiBot testing

##### 7.1.7.2. Tutorials

- DigiKey: Getting Started with KiCad 8 (https://www.youtube.com/watch?v=BVhWh3AsXQs) (30 min)
- KiCad 6 STM32 Beginner Tutorial Series (https://www.youtube.com/playlist?list=PLy2022BX6Eso532xqrUxDT1u2p4VVsg-q)
- Contextual Electronics: Shine On You Crazy KiCad (https://contextualelectronics.com/courses/shine-on-you-crazy-kicad/) (paid course)
- Official KiCad Documentation (https://docs.kicad.org/)

#### 7.1.8. Free Training & Docs

- KiCad source (GitHub mirror) (https://github.com/KiCad/kicad-source-mirror) — official source, linking to the free documentation site above.
- awesome-kicad (https://github.com/joanbono/awesome-kicad) — curated list of free KiCad tutorials, plugins, and libraries.

## 8. Step 5: Mechanical Design (OpenSCAD)

### 8.1. OpenSCAD Renders

#### 8.1.1. pb3-pack

pb3 pack

Figure 21. pb3-pack

Download STL

This is the print-fit gauge: a solid block matching the measured 68×17.8×8mm envelope, embossed with a version marker. 3D print it and try it in the original PB-3 housing before trusting any of the OpenSCAD or KiCad dimensions further downstream.

#### 8.1.2. pb3-fit-check

pb3 fit check

Figure 22. pb3-fit-check

Download STL

This is the digital half of the same fit check. The measured envelope (include-pb3-envelope.scad, shared with pb3-pack) renders transparent around the real PB-3 board, imported from the KiCad STEP/GLB export converted by containers/trimesh (see "Circuit Design & Emulation"). A board that pokes through the envelope walls means the PCB outline needs to shrink; a board that sits fully inside confirms the electrical design fits the envelope pb3-pack proved.

Full physical-compliance chain, measure to board:

1. Measure the original pack (measurements/README.adoc).
2. Model the envelope in OpenSCAD (pb3-pack, above).
3. Print pb3-pack.stl and test it in the real PB-3 housing.
4. Lay out the PCB in KiCad to the same envelope.
5. Import the KiCad board STL into pb3-fit-check and confirm it still fits, catching any drift before ordering boards.

include-pb3-envelope.scad holds the shared envelope dimensions/module. Per ADR-004, include-*.scad files are libraries, skipped by the CI render loop.

#### 8.1.3. Free Training & Docs

- OpenSCAD source & manual links (GitHub) (https://github.com/openscad/openscad) — official project repository; the README links to the full language reference.
- awesome-openscad (https://github.com/dahoo/awesome-openscad) — curated list of free OpenSCAD tutorials, libraries, and example models.

## 9. Step 6: Circuit Design & Emulation (KiCad)

### 9.1. Circuit Design & Emulation

pb3-replacement.kicad_pro (with its .kicad_sch/.kicad_pcb) is the living electrical design for the replacement pack: a 68×17.8×8mm board that takes USB-C 5V in and delivers a regulated 2.0-2.4V deck rail from a 1S LiPo cell.

#### 9.1.1. Component Selection

Each part below was picked from the candidates surveyed in research/README.adoc, chosen for SOT-23-6 footprints (small enough for the enclosure) and for matching the behavior already proven on the clone teardown boards.

CN3058E (charger)

Linear Li-ion/LiPo charge management IC. Takes the USB-C 5V rail, applies CC/CV charging to the cell, and needs only a handful of external passives — important with almost no board area to spare.

DW01A + FS8205A (protection)

Discrete battery management system on the cell tabs. DW01A senses cell voltage and current; FS8205A is the dual N-MOSFET it drives to cut the path on overvoltage, undervoltage, or overcurrent/short. Chosen instead of trusting the charger or buck stage alone, so a fault anywhere downstream still leaves the cell protected.

Buck regulator (TPS61023-class)

Steps the ~3.7V cell rail down to the 2.0-2.4V the deck expects. The feedback resistor sets the output: 100kΩ gives the PB-S5 clone’s default 2.4V; the forum’s 120kΩ swap gives 2.1V. Extrapolating those two points puts 2.0V at roughly 130kΩ — an unverified estimate, not a datasheet value. pb3-replacement.cir models 2.0V directly; confirm the real resistor against the vendor datasheet and bench measurement before fabrication.

OVP clamp (Zener/TVS)

Added on top of what the clone boards do: clamps the output below 3V if the buck stage fails, so the deck never sees the raw 3.7V cell rail.

#### 9.1.2. Circuit Emulation

pb3-replacement.cir is a system-level ngspice model of the proposed pack. It approximates the CN3058E charger, 1S LiPo, DW01A/FS8205A protection, 2.0V buck regulator, 200mA deck load, and output clamp with behavioral sources. It is useful for checking operating points and assumptions. It does not validate the real IC compensation network, stability, thermal behavior, or the unverified AIWA connector pinout.

Run it with ngspice:

ngspice -b -o pb3-replacement.log pb3-replacement.cir
grep -E 'vout_|load_current|vbat' pb3-replacement.log

Expected results: ~1.98V at the deck output, 198mA load current, 3.7V at the idealized cell. The model hard-codes a 2.0V buck target — it does not use the ~130kΩ feedback-resistor estimate above, which is for the real IC’s feedback divider, not this behavioral model. Verify with vendor SPICE models and bench measurements before connecting an AIWA deck. This is the electrical half of the compliance check; the mechanical half is the OpenSCAD fit check.

#### 9.1.3. PCB Routing

pb3-replacement.kicad_pcb places footprints for the 1S protection/buck power path (J1 USB-C, U1 TP4056 charger, U2 DW01A protection IC, Q1 FS8205A dual-FET, U3 buck regulator, J2 deck connector, BT1 LiPo cell) but the schematic (pb3-replacement.kicad_sch) is a block/documentation diagram with global labels only, not real pin-to-pin wiring, and the generic pad numbering on each footprint has no documented mapping to the chips' real pin functions. Nets and copper traces were added directly to the PCB (not derived from the schematic) using verified, datasheet-cited pinouts for the actual parts placed on the board:

- TP4056 (SOIC-8): 1=TEMP, 2=PROG, 3=GND, 4=VCC, 5=BAT, 6=~STDBY, 7=~CHRG, 8=CE.
- DW01A (SOT-23-6): 1=OD, 2=CS, 3=OC, 4=TD, 5=VCC, 6=GND — cross-checked against Fortune Semiconductor datasheet DW01A-DS-12_EN Rev 1.2, Section 6.
- FS8205A (SOT-23-6): 1=S1, 2/5=D12 (common drain), 3=S2, 4=G2, 6=G1.
- TPS62200DBV (SOT-23-5): 1=VIN, 2=GND, 3=EN, 4=FB, 5=SW. The PCB footprint is labelled TPS61023, but the real TI TPS61023 is a 6-pin SOT-563 part that doesn’t match this board’s 5-pad SOT-23-5 footprint. The schematic’s actual symbol for U3 is Regulator_Switching:TPS62200 (a real SOT-23-5 buck), so the TPS62200 pinout was used to route the 5 pads that exist — the footprint name is a pre-existing naming inconsistency in the repo, left unchanged.

Routed nets: VBUS, GND (includes TEMP/CE tied low and the DW01A/FS8205A current-sense node), VBAT (cell/protected-positive rail, includes EN tied high for an always-on regulator), VBAT_RAW_NEG (raw/unprotected cell negative — kept separate from GND so the protection circuit still does its job), and the DW01A→FS8205A gate signals OD/OC.

Several pins are intentionally left as single-pad, unrouted nets (NC_PROG, NC_STDBY, NC_CHRG, NC_TD, NC_FB, NC_SW, NC_VOUT) because the passives their function depends on — the PROG resistor, charger status LEDs, the buck’s inductor, the FB feedback divider, and the output capacitor — do not exist as footprints in this PCB revision (they’re only referenced in the block-diagram schematic). kibot.yaml’s `ignore_unconnected preflight option keeps DRC clean despite this. Adding those passives and wiring them in is a follow-up, not part of this routing pass.

This is a best-effort prototype routing based on standard reference-design pinouts, not a verified production layout — confirm every net against the real datasheets and bench-test before fabrication, same as the existing disclaimers on connector pinout and the feedback resistor value above.

#### 9.1.4. 3D Exports & Renders

Alongside the fabrication outputs (gerbers, drill, position files), kicad-cli (KiCad 9, pcb export/pcb render) produces:

- pb3-replacement.step — STEP solid model, for any MCAD tool.
- pb3-replacement.glb — binary glTF, converted to results/cad/pb3-replacement-board.stl by the containers/trimesh container (rescale, re-axis, re-origin — see its README).
- pb3-replacement-render-top.png / -render-iso.png — photorealistic raytraced renders of the finished board.

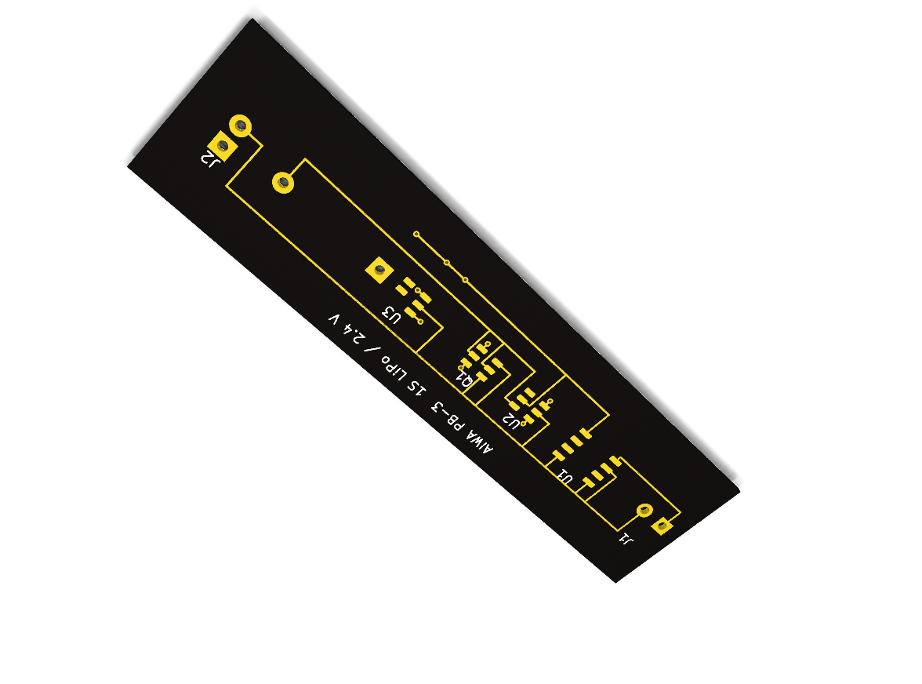
[picture p38: results/kicad/pb3-replacement-render-iso.png]
pb3 replacement render iso


Figure 23. Isometric render of the replacement board

The STL feeds openscad/pb3-fit-check.scad — see "Mechanical Design (OpenSCAD)" for the fit-check render.

#### 9.1.5. Free Training & Docs

- KiCad source (GitHub mirror) (https://github.com/KiCad/kicad-source-mirror) — official KiCad source code; the repository README links to the free documentation site.
- awesome-kicad (https://github.com/joanbono/awesome-kicad) — curated list of free KiCad tutorials, plugins, and libraries.
- ngspice (https://github.com/ngspice/ngspice) — official circuit simulator source and documentation used by "Circuit Emulation" above.
- awesome-electronics (https://github.com/kitspace/awesome-electronics) — curated list of free datasheets, application notes, and component selection references, useful background for "Component Selection".
- glTF specification (https://github.com/KhronosGroup/glTF) — the format behind the .glb export used for the mechanical fit-check.

## 10. Step 7: Architecture Diagrams

### 10.1. PlantUML Diagrams

#### 10.1.1. PB3Architecture

PB3Architecture

Figure 24. PB3Architecture

SVG PNG

#### 10.1.2. Free Training & Docs

- PlantUML (https://github.com/plantuml/plantuml) — official project repository and documentation for the diagram-as-code syntax used here.

## 11. Step 8: Results & Compliance

### 11.1. Results & Compliance

This directory contains outputs generated by the containerized CAD and simulation workflow. Do not edit these files by hand — they are evidence that the design in openscad/, kicad/, and images/ meets the two targets set in the research and reverse-engineering steps: fitting the original 68×17.8×8mm envelope, and delivering a safe, regulated 2.0V rail.

- cad/ — OpenSCAD renders.
- diagrams/ — PlantUML circuit and architecture diagrams.
- kicad/ — KiCad board previews, schematic exports, and fabrication files.
- circuit/ — ngspice logs and measurements.
- docs/ — assembled HTML and PDF documentation (this book).

Rebuild everything with the Build GitHub Actions workflow, or run the container commands in .github/workflows/build.yml locally.

#### 11.1.1. Physical Compliance

pb3 pack

Figure 25. pb3-pack fit-check render

cad/pb3-pack.stl is the printable gauge block for the 68×17.8×8mm outline and 52×15×6mm cell cavity measured in measurements/README.adoc. A print that fits the original PB-3 bay confirms the mechanical envelope before any PCB is fabricated. kicad/pb3-replacement-board.svg and the kicad/fabrication/ gerbers/drill/position files are what a fabricator needs to build the board that has to fit inside that same envelope.

pb3 fit check

Figure 26. pb3-fit-check render: real board (green) inside the measured envelope (transparent)

cad/pb3-fit-check.stl is the digital counterpart to the pb3-pack print test: cad/pb3-replacement-board.stl (converted from kicad/pb3-replacement.glb, see "Circuit Design & Emulation") is imported into the same envelope model. The board fitting entirely inside the transparent walls confirms the KiCad layout matches the physically-verified envelope.

kicad/pb3-replacement.step and .glb are the raw 3D exports of the board, usable in any MCAD/3D tool. kicad/pb3-replacement-render-top.png and -render-iso.png are photorealistic renders of the finished board.

#### 11.1.2. Electrical Compliance

circuit/pb3-replacement.log is the ngspice run of the circuit emulation described in the "Circuit Design & Emulation" step — see that step for the expected pass values. kicad/pb3-replacement-schematic.pdf and -schematic.svg are the schematic exports of the same design.

#### 11.1.3. Toolchain Proof

kicad/batteryPack-schematic.pdf, batteryPack-pcb-top.svg, and batteryPack-pcb-bottom.svg are the outputs of the "KiCad Hello World" toolchain check: the same KiCad → KiBot → CI pipeline used above, proven on a known-good sample project first.

#### 11.1.4. Free Training & Docs

- GitHub Actions documentation (https://docs.github.com/en/actions) — the workflow that renders and commits everything in this directory.
- awesome-actions (https://github.com/sdras/awesome-actions) — curated list of free GitHub Actions building blocks, for anyone adapting this container-based render pipeline.

## 12. Architecture Decisions

### 12.1. Architecture Decision Records

#### 12.1.1. Philosophy

Hemingway

Short sentences. No fluff. Say it once.

DRY (Don’t Repeat Yourself)

Write once. Reference everywhere. No copy-paste.

KISS (Keep It Simple, Stupid)

Simple beats clever. If you need comments, simplify.

NO MAGIC

Explicit over implicit. No hidden behavior. No surprises.

#### 12.1.2. What

ADRs document why we chose this over that.

Each record:

- States the decision
- Lists alternatives considered
- Explains consequences

#### 12.1.3. Why

Memory fades. Context dies. ADRs preserve intent.

When someone asks "why this way?", point to the ADR.

#### 12.1.4. Format

ADR template

= ADR-NNN: Title

Date: YYYY-MM-DD
Status: Accepted | Deprecated | Superseded

== Context
Problem statement. One paragraph.

== Decision
What we chose. One sentence.

== Alternatives
- Option A: why rejected
- Option B: why rejected

== Implications
+ Good consequence
+ Good consequence
- Bad consequence
- Mitigation for bad consequence

#### 12.1.5. Index

##### 12.1.5.1. ADR-001: Commit Generated Artifacts Next to Source

Date: 2025-12-12
Status: Accepted

###### 12.1.5.1.1. Context

This repo is a reverse engineering workbook. PlantUML diagrams, OpenSCAD models, KiCad schematics are both source and documentation. End users clone the repo to read design history, not to rebuild artifacts.

Generated outputs (PNG, STL, PDF) answer: "What does this look like?" Keeping them divorced from source breaks context. Viewing design requires tools. History loses meaning without rendered outputs.

###### 12.1.5.1.2. Decision

Commit generated artifacts next to their source files.

###### 12.1.5.1.3. Alternatives

Separate docs/generated/ directory

+ Clean source tree + CI manages all outputs

- Divorces outputs from source context
- Requires CI to view design
- Clone without CI = incomplete artifact
- AsciiDoc references break (image::openscad/foo.png fails if PNG lives in docs/)

Ignore all generated files

+ Smallest repo + No merge conflicts on binaries

- Useless offline
- GitHub PR can’t show visual diffs
- Design evolution invisible in history

Submodule for outputs

+ Separates binary history

- Overcomplicated for solo project
- Two clones to see one design

###### 12.1.5.1.4. Implications

Positive:

+ openscad/pb3-pack.png lives next to openscad/pb3-pack.scad + AsciiDoc image:: paths match file tree + Offline clone shows design without rebuilding + GitHub renders PNGs inline in PRs + History shows design evolution (old PNG = old intent) + No CI dependency for documentation

Negative:

- Repo size grows with each design iteration
- Merge conflicts possible on binary files (rare for solo)
- CI must commit and push outputs

Mitigations:

- Keep STL/PNG <5MB each (current sizes: <500KB)
- Use git lfs if files exceed 10MB
- CI commits with [skip ci] to avoid recursion
- For huge experimental outputs, use scratch build/ dirs (gitignored)

###### 12.1.5.1.5. Files Affected

Source directories commit their outputs:

- openscad/*.{stl,png} — rendered models
- images/*.{png,svg} — diagram exports
- kicad/*.{pdf,svg} — schematic/board renders

CI workflow updated to:

1. Generate artifacts into source directories
2. Commit outputs back to repo
3. Push to main branch

Scratch builds (local experiments) use */build/ and remain gitignored.

##### 12.1.5.2. ADR-002: Use Text-Based CAD and Documentation Formats

Date: 2025-12-12
Status: Accepted

###### 12.1.5.2.1. Context

Reverse engineering requires clear, searchable, versionable documentation. Design intent must survive iteration. Ambiguity kills projects. Binary formats (PNG, SVG, proprietary CAD) hide structure, resist search, and depend on artistic interpretation.

Need tools that:

- Version cleanly in git
- Search with grep
- Feed to LLMs without image parsing
- Embed measurements explicitly
- Avoid subjective interpretation

###### 12.1.5.2.2. Decision

Use text-based formats for all CAD and documentation:

- AsciiDoc for all docs
- PlantUML for block diagrams
- OpenSCAD for mechanical models
- KiCad for PCB (S-expression text format)

###### 12.1.5.2.3. Alternatives

Binary formats (Visio, Fusion 360, PNG diagrams)

+ Industry standard tools + Rich GUI workflows

- Not searchable (grep useless)
- Binary diffs meaningless
- LLM can’t parse structure
- Locked to specific tools
- Measurements hidden in pixels
- Interpretation varies by viewer

Markdown + hand-drawn SVG

+ Simple, portable

- SVG is XML (verbose, hard to write)
- Hand-drawn = ambiguous dimensions
- No parametric models
- Design intent lost in pixels

Wiki or Google Docs

+ Collaborative + Rich media

- Not in git (history scattered)
- Export fragile
- Offline broken
- Search locked to platform

###### 12.1.5.2.4. Implications

Positive:

+ grep "68.*17.8.*8" openscad/ finds all references to pack dimensions + git diff shows exact measurement changes: outer_len = 67 → outer_len = 68 + LLM can ingest .puml and suggest corrections: "2.4V output conflicts with 2.0V spec" + PlantUML connections are explicit: CELL -→ BUCK : 3.0-4.2V (no guessing from arrows) + OpenSCAD embeds tolerances: wiggle=.01 (visible in source, not CAD property panel) + KiCad .kicad_sch is S-expression: searchable for part numbers, net names + Docs live next to code: openscad/pb3-pack.scad + README.asciidoc in same commit + Dead docs impossible: if code changes, doc changes (same file or adjacent) + No priest needed: outer_len = 68 means 68mm, not "roughly this wide"

Negative:

- Steeper learning curve (PlantUML syntax, OpenSCAD code)
- No WYSIWYG (must render to see)
- Collaboration requires text-editing skill
- Binary export still needed for viewing (PNG, STL)

Mitigations:

- CI auto-generates viewable outputs (PNG, STL, PDF) from text sources
- Commit both source and renders (ADR-001)
- Include examples in repo (images/pb3-architecture.plantuml as template)
- LLMs can write PlantUML/OpenSCAD from specs (reverse engineering ally)

###### 12.1.5.2.5. Examples

Searchable dimensions:

outer_len = 68;    // grep finds this
outer_width = 17.8;

Explicit connections:

CELL --> BUCK : 3.0-4.2V  // no guessing voltage
BUCK --> OUT : 2.0V       // explicit output

Versionable structure:

- BUCK --> OUT : 2.4V
+ BUCK --> OUT : 2.0V  // git diff shows intent change

LLM-friendly input: "Here’s the PlantUML. Does the 2.0V output match the schematic’s buck feedback resistor?"

###### 12.1.5.2.6. Tools Used

- AsciiDoc: prose, specs, workbook
- PlantUML: block diagrams, architecture
- OpenSCAD: mechanical models, fit tests
- KiCad: schematic + PCB (text-based S-expression format)

All text. All searchable. All versionable. All LLM-ingestible.

##### 12.1.5.3. ADR-003: Use GitHub Actions for All Build Automation

Date: 2025-12-12
Status: Superseded by ADR-006 (single job pipeline)

###### 12.1.5.3.1. Context

Generated artifacts (PNG, STL, PDF) must stay synchronized with source files. Manual builds fail. Developers forget to regenerate. Wrong versions ship. "It works on my machine" breaks collaboration.

Need automation that:

- Runs on every commit
- Links builds to exact source version
- Prevents stale outputs
- Documents build process explicitly
- Survives author memory loss

###### 12.1.5.3.2. Decision

Use GitHub Actions for all CAD rendering and artifact generation.

No local build scripts as primary workflow.

###### 12.1.5.3.3. Alternatives

Local build scripts only

+ Fast iteration + No network dependency

- Forget to run = stale outputs committed
- "Works on my machine" inconsistencies
- Process lives in author’s head
- New contributor: "How do I build?"
- No proof outputs match sources

Manual screenshot/export workflow

+ Simple tools + No scripting

- Wrong version screenshots plague repos
- No traceability (which source made this PNG?)
- Forgot to save = weeks hunting mismatch
- Undocumented steps = tribal knowledge

Pre-commit hooks

+ Automatic on commit

- Slow local commits (blocks developer)
- Hard to debug when broken
- Environmental differences break hooks
- Still local = "works on my machine"

Makefile + CI

+ Standard Unix pattern + Local + remote builds

- Two build paths = drift risk
- Makefile syntax arcane
- Windows developers struggle
- Process still partly hidden

###### 12.1.5.3.4. Implications

Positive:

+ Sync guaranteed: outputs regenerated every push, impossible to commit stale PNG + Traceable: Actions log links to exact commit that built artifact + Documented workflow: .github/workflows/cad-build.yml IS the build documentation + Preview while editing: PlantUML/OpenSCAD extensions show live preview in VS Code, no surprise when CI builds + Repeatable: same Docker images, same results, always + Inspectable: workflow file shows thought process: "first OpenSCAD, then PlantUML, then publish" + No magic: workflow is code, not author’s mental model requiring MRI to extract + Works-on-merge: GitHub Actions runs on forks, contributors see build before PR + Blame trail: git log shows when output changed and why (CI commit message references source change)

Negative:

- Network required to see final outputs (mitigated: local preview extensions)
- Slower feedback than local build (mitigated: preview extensions, small changes iterate locally)
- CI quota consumption (mitigated: build only on source file changes)
- Initial setup cost (one-time, then keeps working)

Mitigations:

- VS Code extensions preview PlantUML/OpenSCAD during editing (instant feedback)
- Actions trigger only on paths: openscad/, images/, kicad/** (skip unrelated commits)
- Local Docker containers available for manual iteration (same images CI uses)
- Workflow continues on job failure: continue-on-error: true (partial build better than none)

###### 12.1.5.3.5. Why Not Magic

Actions EXPOSE process:

# This is the build documentation. No hidden steps.
- name: Render
  run: |
    docker run ... openscad -o /w/build/openscad/$s.stl /w/$f

Compare to undocumented mental model: - Author: "I open OpenSCAD, export STL, save PNG, commit both" - New contributor: "Which settings? What colorscheme? Why this size?" - Six months later: "How did I make this?"

Actions preserve intent. Author leaves. Process survives.

###### 12.1.5.3.6. Workflow Structure

cad-build.yml:

1. openscad job: render STL + PNG for all .scad files
2. plantuml job: render SVG for all .puml files
3. kicad job: render PDF + SVG via KiBot
4. publish job: commit outputs back to repo (ADR-001)

Each job: - Runs in isolation - Uses pinned Docker image (versioned, reproducible) - Continues on error (partial build survives) - Logs exact commands (auditable)

###### 12.1.5.3.7. Traceability Example

Commit: fix: correct outer_len to 68mm

Actions runs → generates new STL → commits:

ci: refresh outputs

Generated from:
- openscad/pb3-pack.scad (abc1234)

Git blame on pb3-pack.stl → points to CI commit → references source commit → full trace.

No "oops wrong image" mystery.

###### 12.1.5.3.8. Living Documentation

Workflow file = build manual.

New contributor clones repo, reads .github/workflows/cad-build.yml, understands: - Which Docker images - Which commands - Which outputs - Which paths trigger

No MRI. No author interview. Just code.

###### 12.1.5.3.9. Tools vs Process

Local preview: VS Code extensions (instant feedback while editing)

Canonical build: GitHub Actions (guarantees sync, documents process)

Both. Not either/or.

##### 12.1.5.4. ADR-004: File Extension Conventions for Main vs Include Files

Date: 2025-12-12
Status: Accepted

###### 12.1.5.4.1. Context

Repos accumulate many AsciiDoc and PlantUML files. Finding the main entry point becomes hard. Need convention to distinguish "main documentation" from "included fragments" and "build sources" from "style imports".

Without convention: - Which .adoc is the root doc? - Which .puml gets rendered? - Grep returns too many false positives

###### 12.1.5.4.2. Decision

Use extension suffixes to signal file role:

AsciiDoc: - .asciidoc = main documentation (entry points) - .adoc = include fragments (not standalone) - includes/*.adoc = shared fragments (glossary, copyright, formatting macros)

PlantUML: - .plantuml = diagrams to render - .puml = style/config imports (not rendered)

OpenSCAD: - .scad = models to render - include-*.scad = libraries (modules/functions only, skip rendering)

Build outputs: - Always adjacent to source (ADR-001) - docs/ = rendered AsciiDoc HTML only - .png, .stl, .svg live next to .scad/.plantuml

###### 12.1.5.4.3. Alternatives

All use same extension

+ Simpler

- No way to find main docs fast
- Glob *.adoc catches 47 files
- New contributor: "Which one do I read?"

Separate directories

+ Clear grouping: main/, includes/

- Breaks locality (main doc far from includes)
- Path references fragile

Metadata in filename

+ Example: README.main.adoc

- Ugly
- Sorting broken

###### 12.1.5.4.4. Implications

Positive:

+ find . -name ".asciidoc" → main docs only + find . -name ".plantuml" → diagrams to render + CI glob: images/*.plantuml (ignores common.puml style) + New contributor sees README.asciidoc and knows: "Start here" + Include detection: grep "^include::" *.adoc finds fragments + Clear intent: .asciidoc = public, .adoc = internal

Negative:

- Convention not obvious without docs
- Mix of extensions in directory listings

Mitigations:

- Document in ADR (this file)
- Enforce in CI: fail if .asciidoc includes another .asciidoc
- README mentions convention

###### 12.1.5.4.5. Examples

README.asciidoc                      ← main doc (read this first)
pb3-notes.asciidoc                   ← main workbook
adr/README.adoc                      ← include fragment (embedded in parent)
adr/adr-001-foo.adoc                 ← include fragment
includes/include-glossary.adoc       ← shared fragment (glossary)
includes/include-copyright.adoc      ← shared fragment (license boilerplate)

images/pb3-architecture.plantuml  ← render this
images/common.puml                ← style import (not rendered)

openscad/pb3-pack.scad            ← render this
openscad/include-utils.scad       ← library (skip rendering)
openscad/pb3-pack.png             ← output (adjacent)
openscad/pb3-pack.stl             ← output (adjacent)

###### 12.1.5.4.6. Directory Structure

docs/                    ← HTML output from asciidoc rendering only
includes/                ← Shared AsciiDoc fragments (glossary, copyright, macros)
openscad/*.{png,stl}     ← CAD outputs (adjacent to .scad)
images/*.{png,svg}       ← diagram outputs (adjacent to .plantuml)
kicad/*.{pdf,svg}        ← schematic/PCB outputs (adjacent to .kicad_*)

No generated artifacts in docs/generated/. That pattern is deprecated (ADR-001).

###### 12.1.5.4.7. CI Impact

Workflows use extension filters:

for f in images/*.plantuml; do  # not *.puml
  plantuml "$f"
done

for f in openscad/*.scad; do
  [[ "$(basename "$f")" =~ ^include- ]] && continue  # skip libraries
  openscad -o "${f%.scad}.stl" "$f"
  openscad -o "${f%.scad}.png" "$f"
done

AsciiDoc rendering looks for *.asciidoc only.

##### 12.1.5.5. ADR-005: Conditional imagesdir Management for Book Assembly

Date: 2025-12-12
Status: Accepted

###### 12.1.5.5.1. Context

README.asciidoc assembles multiple .adoc fragments that contain images. Each fragment must work both:

1. Standalone: rendered directly (GitHub, local preview)
2. Included: assembled into main book

Problem: image paths break when included.

Example: - images/README.adoc contains image::diagram.png[] - Standalone: works (PNG is local) - Included in root README: fails (looks for diagram.png in root, not images/)

Need: conditional :imagesdir: that adapts to context without breaking either mode.

###### 12.1.5.5.2. Decision

Use :flag-book: to conditionally manage :imagesdir:.

Main document (README.asciidoc):

Set book mode flag

//:flag-book: true

Each included fragment:

Save, override, restore imagesdir

//ifdef::flag-book[]
//:imagesdir-save: {imagesdir}
//:imagesdir: <subdirectory>
//endif::[]
//
//... content with images ...
//
//ifdef::flag-book[]
//:imagesdir: {imagesdir-save}
//endif::[]

###### 12.1.5.5.3. Alternatives

Absolute paths in image macros

+ Works both standalone and included

- Fragile (breaks on repo rename)
- Verbose: image::images/diagram.png[] everywhere
- Not idiomatic AsciiDoc

Duplicate files

+ Clean separation

- Maintenance nightmare
- Violates DRY
- Drift guaranteed

Separate standalone vs include versions

+ Each optimized for context

- Double maintenance
- Violates single source of truth

Always use subdirectory paths

+ Simple

- Breaks standalone rendering
- GitHub can’t preview

###### 12.1.5.5.4. Implications

Positive:

+ Single source: one .adoc file, two render contexts + Standalone works: images/README.adoc previews correctly on GitHub + Book works: README.asciidoc assembles all fragments with correct image paths + No path duplication: image::foo.png[] not image::images/foo.png[] + Graceful fallback: if :flag-book: not set, standalone mode assumed + Restores state: :imagesdir-save: preserves any parent setting

Negative:

- Boilerplate: every fragment needs ifdef blocks
- Non-obvious: requires ADR to explain
- Fragile: forget closing block = broken subsequent includes

Mitigations:

- Document pattern in ADR (this file)
- CI-generated READMEs include pattern automatically
- Template in includes/include-toc-standalone.adoc for manual fragments
- Lint rule: fail if :imagesdir: changed without restore

###### 12.1.5.5.5. Pattern

Step 1: Main doc sets flag

Main document

//= Main Document
//:flag-book: true
//
//include::subdoc/README.adoc[]

Step 2: Subdoc saves and overrides

Subdocument with conditional path

//= Subdoc
//ifdef::flag-book[]
//:imagesdir-save: {imagesdir}
//:imagesdir: subdoc
//endif::[]
//
//image::photo.png[]  // standalone: subdoc/photo.png, book: subdoc/photo.png

Step 3: Subdoc restores at end

Restore parent context

//... last image ...
//
//ifdef::flag-book[]
//:imagesdir: {imagesdir-save}
//endif::[]

###### 12.1.5.5.6. Files Using Pattern

Manual: - measurements/README.adoc

CI-generated: - images/README.adoc - openscad/README.adoc

Template: - includes/include-toc-standalone.adoc (provides ifdef block)

###### 12.1.5.5.7. Why Save/Restore

Simple reset (:imagesdir:) loses parent context:

Wrong: loses parent setting

//:imagesdir: assets         // parent sets this
//
//include::sub/doc.adoc[]    // sub sets :imagesdir: sub, then resets to empty
//                           // WRONG: parent's "assets" is lost

Save/restore preserves nesting:

Correct: preserves parent setting

//:imagesdir: assets
//
//include::sub/doc.adoc[]    // saves "assets", sets "sub", restores "assets"
//                           // CORRECT: parent context preserved

Enables arbitrary nesting depth without coordination.

##### 12.1.5.6. ADR-006: Single Job Render Pipeline

Date: 2025-12-12
Status: Accepted
Supersedes: ADR-003

###### 12.1.5.6.1. Context

Initial CI used separate jobs for OpenSCAD, PlantUML, AsciiDoc (ADR-003). Each job committed separately. Parallel execution caused git push race conditions. Pull/rebase before each push worked but created noisy history: three bot commits per design change.

AsciiDoc embeds outputs from OpenSCAD and PlantUML. Files must exist before asciidoctor runs. Separate jobs required artifact upload/download. Slow. Complex.

###### 12.1.5.6.2. Decision

Single render job, sequential steps, one commit.

jobs:
  render:
    steps:
      - Render KiCad → *.pdf, *.svg, *.step, *.glb, *-render-*.png
      - Convert board GLB → *.stl (for the OpenSCAD fit-check)
      - Render OpenSCAD → *.stl, *.png
      - Render PlantUML → *.svg, *.png
      - Build AsciiDoc → docs/*.{html,pdf}
      - Commit all outputs

KiCad now runs first: openscad/pb3-fit-check.scad imports a board STL converted from the KiCad STEP/GLB export, so that conversion must exist before the OpenSCAD step runs.

###### 12.1.5.6.3. Alternatives

Parallel jobs with artifacts

+ Faster (concurrent renders)

- Upload/download overhead (30s)
- Three commits per change
- Race conditions on push
- Complex artifact handling

Sequential jobs

+ Clear dependencies + No artifacts needed

- Slower (no parallelism)
- Still three commits

Local Makefile

+ Fast iteration

- ADR-003 rejected this (stale outputs)

###### 12.1.5.6.4. Implications

Positive:

+ One commit: ci: render all outputs [skip ci] + No race conditions + Shared filesystem (no artifacts) + AsciiDoc sees all PNGs/SVGs immediately + Simple: pipeline reads top-to-bottom + Fast: no artifact marshaling

Negative:

- Sequential (no parallel speedup)
- Single failure blocks all downstream

Mitigations:

- Renders are fast (<2min total)
- Debug mode shows which step failed
- Continue-on-error for non-critical steps

###### 12.1.5.6.5. Why Not Jobs

Jobs = parallelism or isolation. This is a pipeline: KiCad → OpenSCAD → PlantUML → AsciiDoc. Dependencies are linear. Output files feed next step. One job, shared filesystem, done.

###### 12.1.5.6.6. Pattern

- name: Render Tool
  run: |
    [[ "$DEBUG" == "true" ]] && echo "=== Finding files ==="
    for f in $(find . -name "*.ext"); do
      docker run --rm -v "$PWD":/w $IMG tool -o output $f
    done

All tools follow same structure: 1. Find source files 2. Render with Docker container 3. Output next to source

Final step adds all outputs, commits once.

#### 12.1.6. Free Training & Docs

- MADR — Markdown Architectural Decision Records (https://github.com/adr/madr) — the free, GitHub-hosted format this convention is based on.
- adr-tools (https://github.com/npryce/adr-tools) — command-line tools for managing ADRs, useful reference for numbering/indexing conventions.

## 13. Credits

- Stereo2Go forum (https://stereo2go.com/forums/threads/rechargeable-battery-replacement-for-aiwa-pb-3-pb-4.9025/) — original research
- OpenSCAD: ghcr.io/donnels/openscad:main (https://github.com/donnels/openscad)
- PlantUML: ghcr.io/donnels/plantuml:main (https://github.com/donnels/plantuml)
- KiBot: INTI-CMNB/KiBot@v2_dk8 (https://github.com/INTI-CMNB/KiBot)

## 14. Containerized builds

Every step in the Build workflow runs in a container — OpenSCAD, PlantUML, KiCad, AsciiDoc, ngspice, and the GLB→STL board conversion. Nothing installs directly on the runner. Generated renders, diagrams, fabrication files, simulation logs, and documents are committed under results/. Locally-built images (ngspice, trimesh) and their Dockerfiles live in containers/, each with its own README.

1. In-house photo set measurements/IMG_9373.jpeg–IMG_9385.jpeg.

2. Rossoe et al., "Rechargeable battery replacement for AIWA PB-3 / PB-4," Stereo2Go forums, Sep 2023–Apr 2025. Offline copy: research/Rechargeable battery replacement for AIWA PB-3 _ PB-4 _ Stereo2Go forums.html. Original URL: https://stereo2go.com/forums/threads/rechargeable-battery-replacement-for-aiwa-pb-3-pb-4.9025/

Last updated 2026-09-06 14:30:26 UTC
