donnels/aiwa-pb-3/results/diagrams/action.png

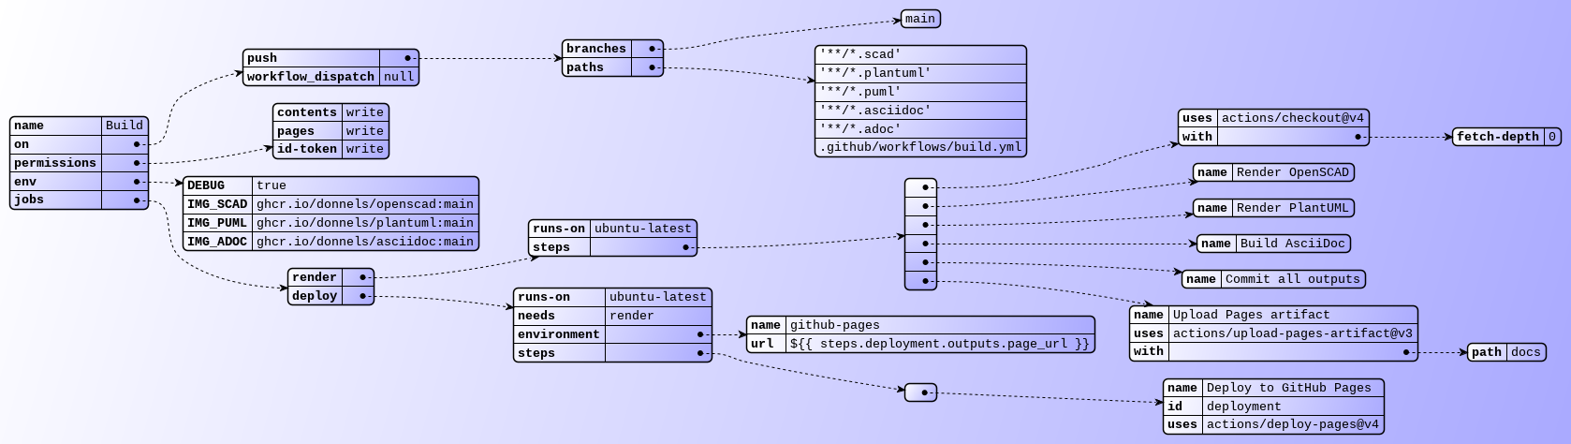
results/diagrams/action.png
