donnels/aiwa-pb-3/results/kicad/pb3-replacement-render-top.png

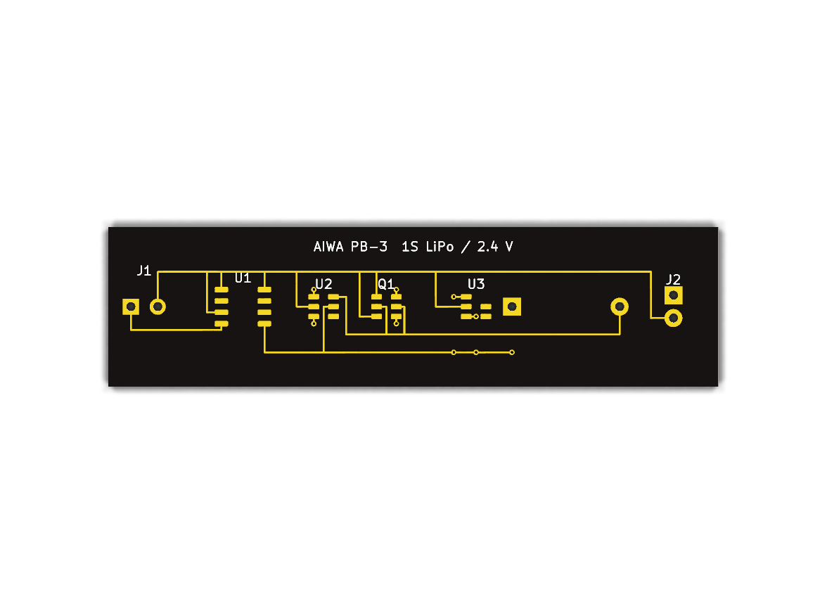
results/kicad/pb3-replacement-render-top.png
