donnels/aiwa-pb-3/kicad-hello-world/batteryPack-schematic.pdf

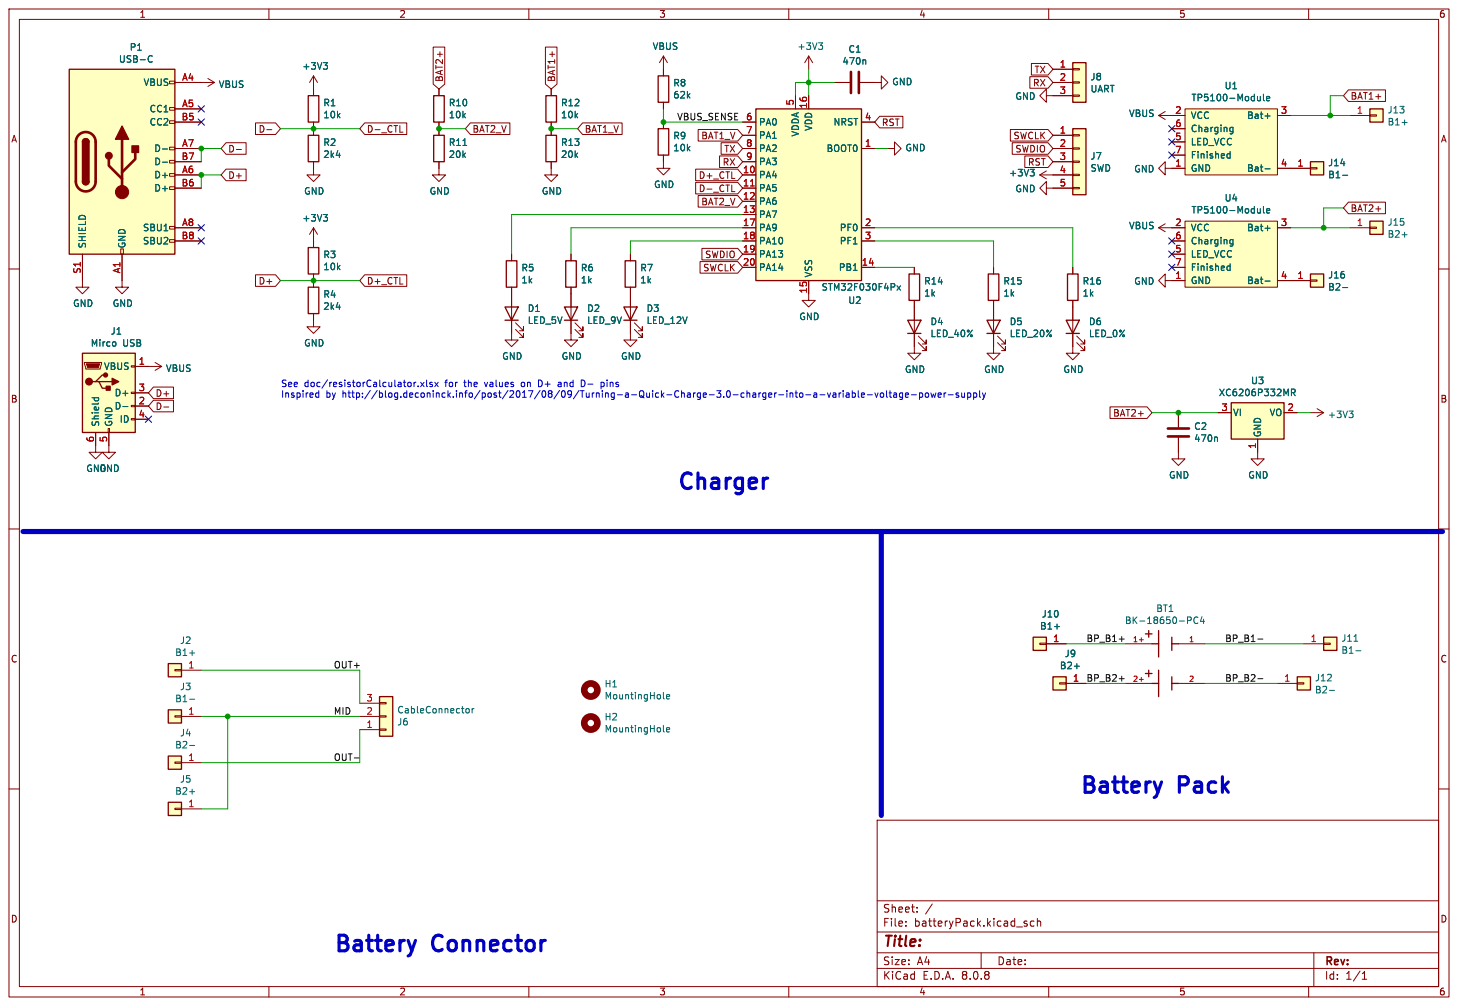
[picture p41: page 1]

5 PA0 6 PA1 7 PA2 8 PA3 9 U1 TP5100-ModuleBat- 4 GND 1 VCC 2 Bat+ 3

1 VO 2 VI 3 GND GND

J7SWD +3V3
VBUS GND GND GND

Inspired by http://blog.deconinck.info/post/2017/08/09/Turning-a-Quick-Charge-3.0-charger-into-a-variable-voltage-power-supply

Id: 1/1 Title: File: batteryPack.kicad_sch Sheet: /
