donnels/aiwa-pb-3/results/kicad/pb3-replacement-schematic.pdf

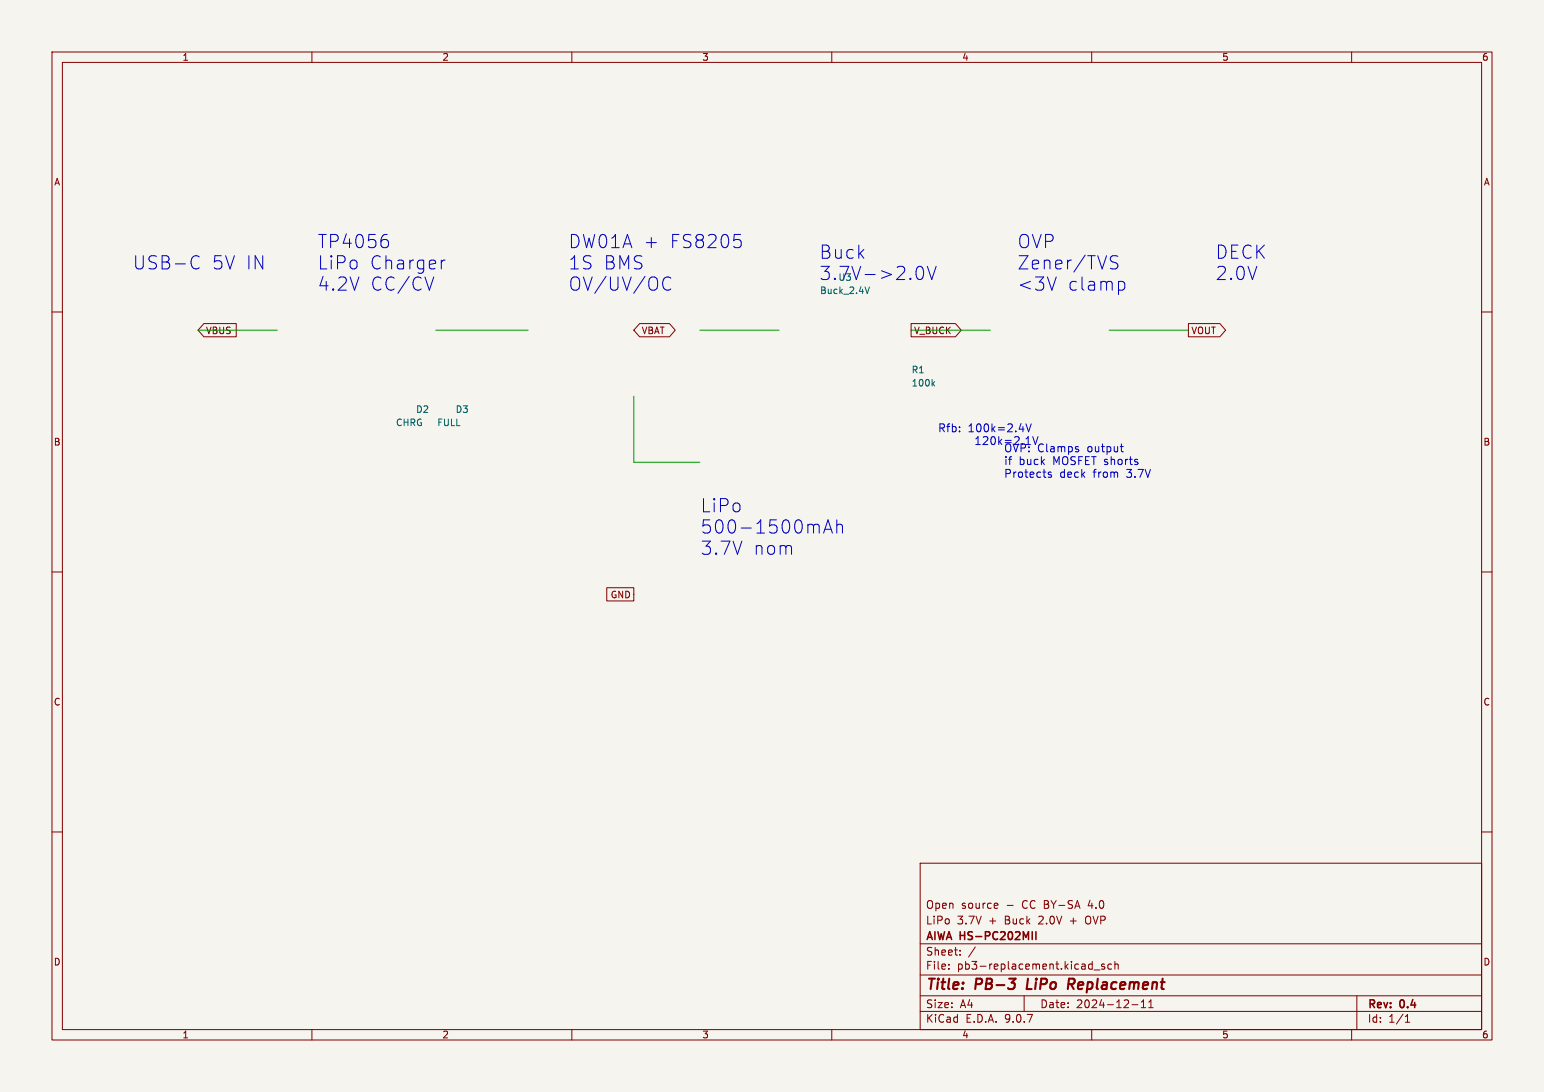
[picture p42: page 1]
