donnels/aiwa-pb-3/kicad/pb3-replacement.kicad_pcb

## KiCad design kicad/pb3-replacement.kicad_pcb (2026-09-06)

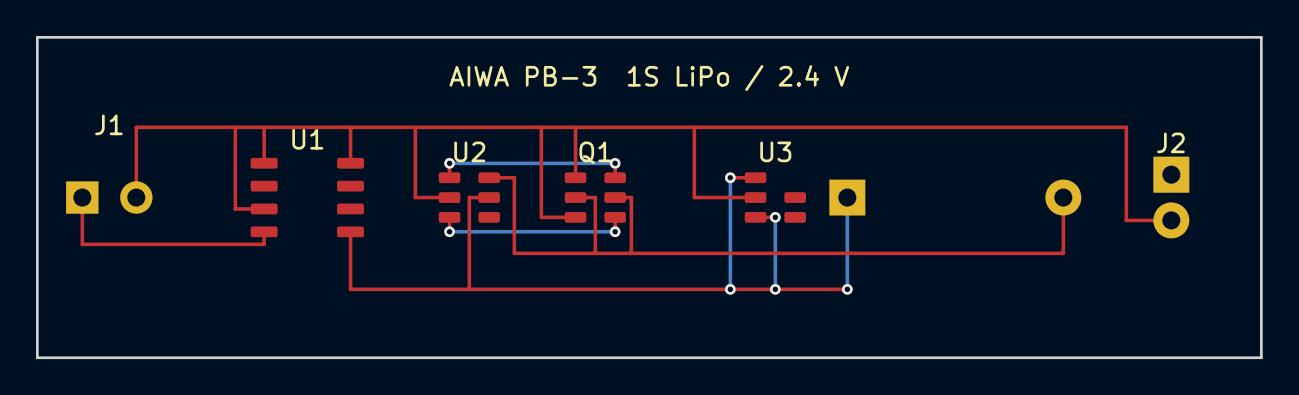
[picture p43: board pb3-replacement.kicad_pcb from above]

Board: 2 copper layers, 68.0 x 17.8 mm, 7 parts (1 on the bottom side), 6 nets.

Parts:
BT1: LiPo_3.7V_500-1500mAh; PB3_LIPO_68x17.8mm
J1: USB_C_5V_IN; PB3_USB_C
J2: AIWA_DECK_2.4V; PB3_DECK_CONNECTOR
Q1: FS8205A; PB3_FS8205A_SOT23-6
U1: TP4056; PB3_TP4056_SOIC8
U2: DW01A; PB3_DW01A_SOT23-6
U3: TPS61023_2.4V; PB3_TPS61023_SOT23-5

Connections:
GND: J1.2, J2.2, Q1.1, Q1.3, U1.1, U1.3, U1.8, U2.2, U3.2
OC: Q1.4, U2.3
OD: Q1.6, U2.1
VBAT: BT1.1, U1.5, U2.5, U3.1, U3.3
VBAT_RAW_NEG: BT1.2, Q1.2, Q1.5, U2.6
VBUS: J1.1, U1.4
