donnels/aiwa-pb-3/kicad-hello-world/batteryPack.kicad_pcb

## KiCad design kicad-hello-world/batteryPack.kicad_pcb (2025-12-13)

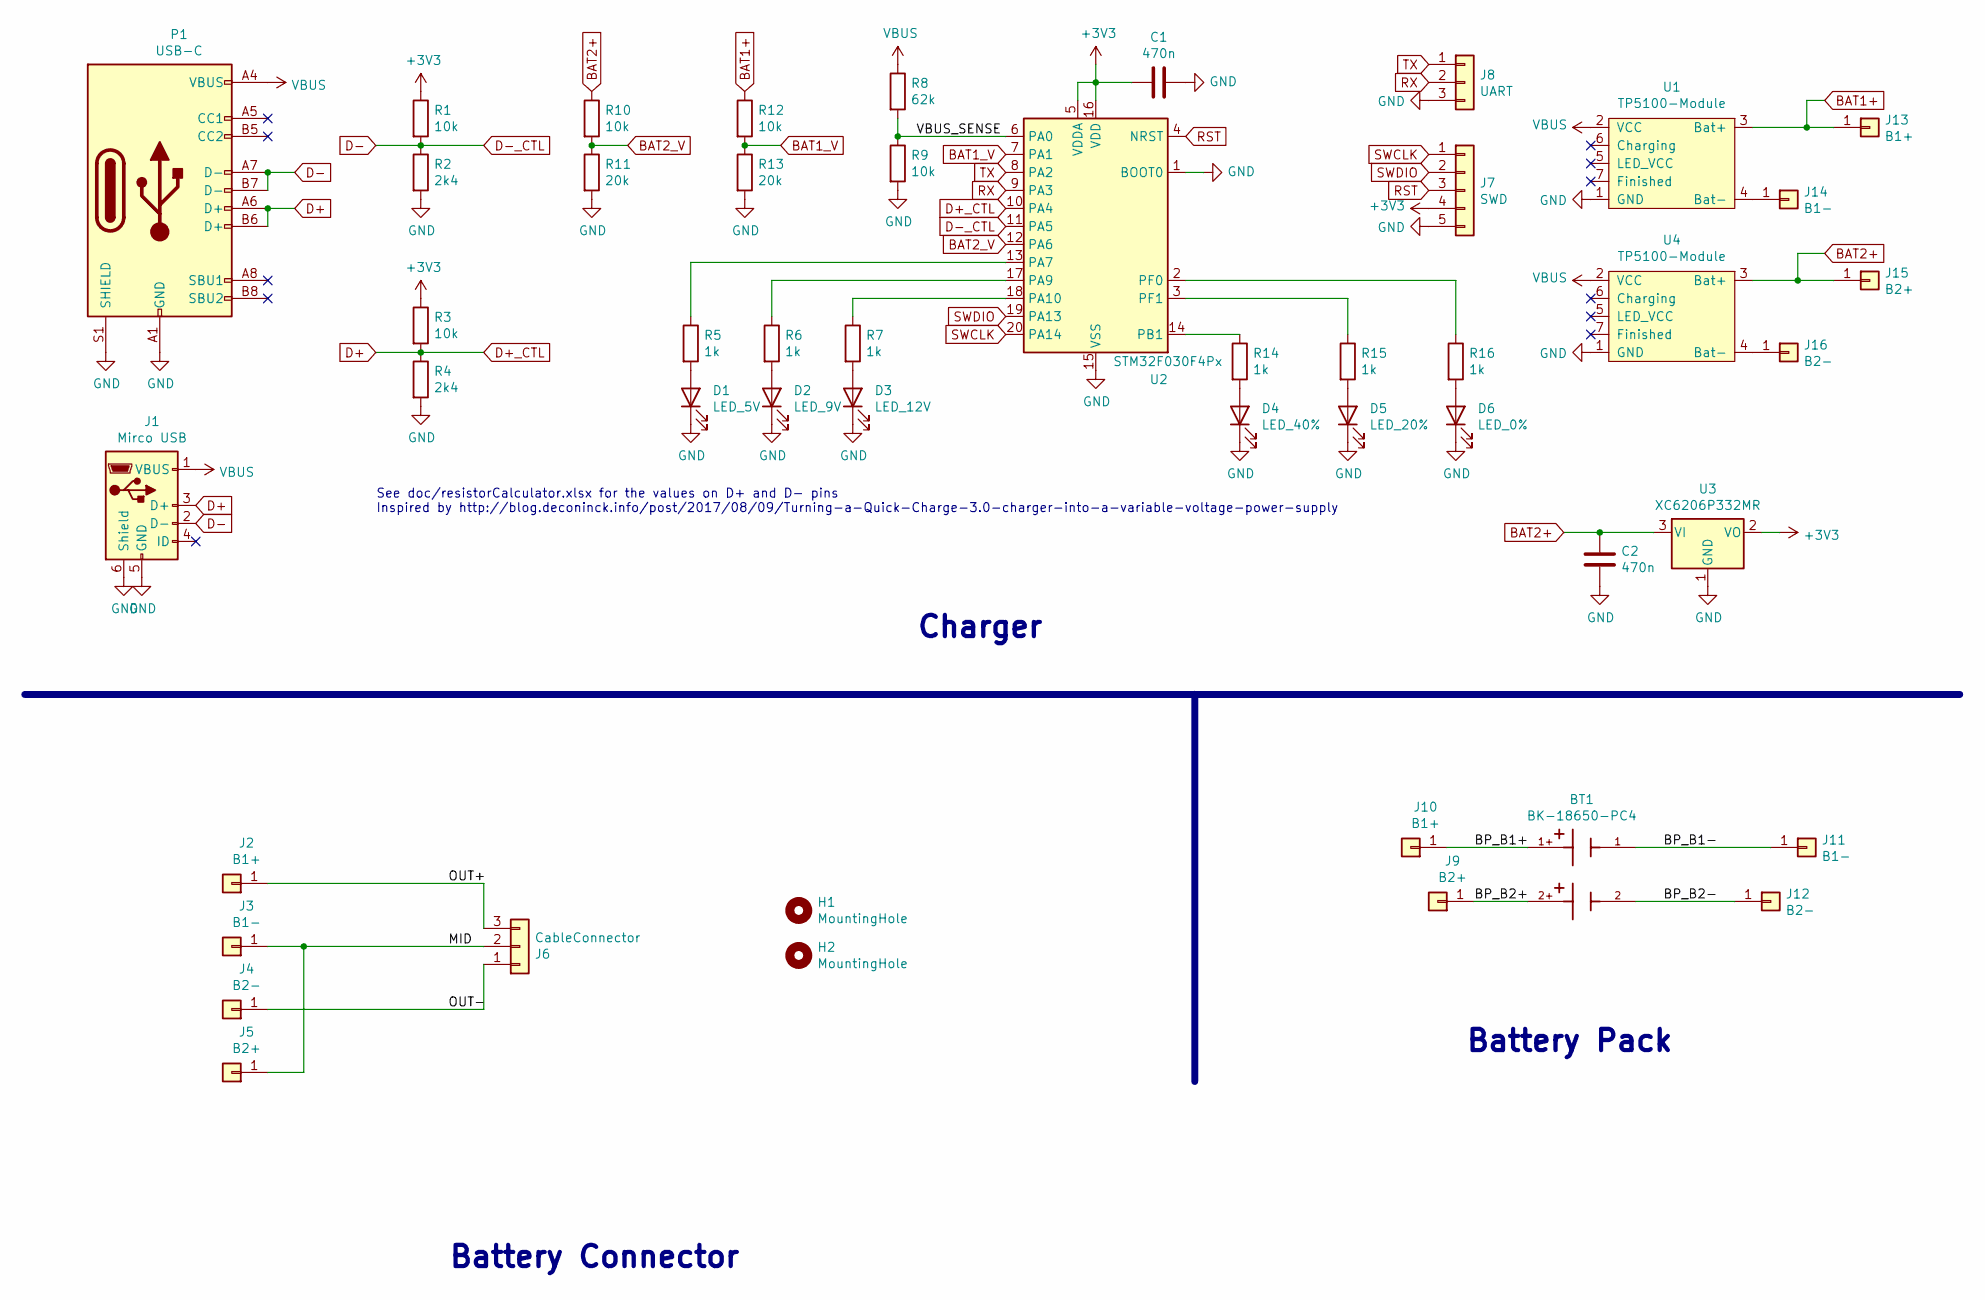
[picture p44: schematic batteryPack.kicad_sch]

Parts:
BT1: BK-18650-PC4; BAT_BK-18650-PC4
C1, C2: 470n; C_0603_1608Metric_Pad1.05x0.95mm_HandSolder
D1: LED_5V; LED_0603_1608Metric_Pad1.05x0.95mm_HandSolder
D2: LED_9V; LED_0603_1608Metric_Pad1.05x0.95mm_HandSolder
D3: LED_12V; LED_0603_1608Metric_Pad1.05x0.95mm_HandSolder
D4: LED_40%; LED_0603_1608Metric_Pad1.05x0.95mm_HandSolder
D5: LED_20%; LED_0603_1608Metric_Pad1.05x0.95mm_HandSolder
D6: LED_0%; LED_0603_1608Metric_Pad1.05x0.95mm_HandSolder
H1, H2: MountingHole; MountingHole_3.2mm_M3
J1: Mirco USB; USB_Micro-B_Wuerth_629105150521_CircularHoles
J2: B1+; 2mm_Banana-Vertical
J3: B1-; 2mm_Banana-Vertical
J4: B2-; 2mm_Banana-Vertical
J5: B2+; 2mm_Banana-Vertical
J6: CableConnector; Terminal_1x03_P5.08mm_Horizontal
J7: SWD; PinHeader_1x05_P2.54mm_Vertical
J8: UART; PinHeader_1x03_P2.54mm_Vertical
J9: B2+; 2mm_Banana-Socket
J10: B1+; 2mm_Banana-Socket
J11: B1-; 2mm_Banana-Socket
J12: B2-; 2mm_Banana-Socket
J13: B1+; 2mm_Banana-Plug
J14: B1-; 2mm_Banana-Plug
J15: B2+; 2mm_Banana-Plug
J16: B2-; 2mm_Banana-Plug
P1: USB-C; USB_C_Female-16Pin-HPJF
R1, R3, R9, R10, R12: 10k; R_0603_1608Metric_Pad1.05x0.95mm_HandSolder
R2, R4: 2k4; R_0603_1608Metric_Pad1.05x0.95mm_HandSolder
R5, R6, R7, R14, R15, R16: 1k; R_0603_1608Metric_Pad1.05x0.95mm_HandSolder
R8: 62k; R_0603_1608Metric_Pad1.05x0.95mm_HandSolder
R11, R13: 20k; R_0603_1608Metric_Pad1.05x0.95mm_HandSolder
U1, U4: TP5100-Module
U2: STM32F030F4Px; TSSOP-20_4.4x6.5mm_P0.65mm
U3: XC6206P332MR; SOT-23

Connections:
+3V3: C1.2, J7.4, R1.1, R3.1, U2.5 (VDDA), U2.16 (VDD), U3.2 (VO)
/BP_B1+: BT1.1+, J10.1
/BP_B1-: BT1.1 (1-), J11.1
/BP_B2+: BT1.2+, J9.1
/BP_B2-: BT1.2 (2-), J12.1
/MID: J3.1, J5.1, J6.2
/OUT+: J2.1, J6.3
/OUT-: J4.1, J6.1
/VBUS_SENSE: R8.2, R9.1, U2.6 (PA0)
BAT1+: J13.1, R12.1, U1.3 (Bat+)
BAT1_V: R12.2, R13.1, U2.7 (PA1)
BAT2+: C2.2, J15.1, R10.1, U3.3 (VI), U4.3 (Bat+)
BAT2_V: R10.2, R11.1, U2.12 (PA6)
D+: J1.3 (D+), P1.A6 (D+), P1.B6 (D+), R3.2, R4.1, U2.10 (PA4)
D-: J1.2 (D-), P1.A7 (D-), P1.B7 (D-), R1.2, R2.1, U2.11 (PA5)
GND: C1.1, C2.1, D1.1 (K), D2.1 (K), D3.1 (K), D4.1 (K), D5.1 (K), D6.1 (K), J1.5 (GND), J1.6 (Shield), J7.5, J8.3, P1.A1 (GND), P1.A12 (GND), P1.B1 (GND), P1.B12 (GND), P1.S1 (SHIELD), R2.2, R4.2, R9.2, R11.2, R13.2, U1.1 (GND), U2.1 (BOOT0), U2.15 (VSS), U3.1 (GND), U4.1 (GND)
unnamed: D1.2 (A), R5.2
unnamed: D2.2 (A), R6.2
unnamed: D3.2 (A), R7.2
unnamed: D4.2 (A), R14.2
unnamed: D5.2 (A), R15.2
unnamed: D6.2 (A), R16.2
unnamed: J14.1, U1.4 (Bat-)
unnamed: J16.1, U4.4 (Bat-)
unnamed: R5.1, U2.13 (PA7)
unnamed: R6.1, U2.17 (PA9)
unnamed: R7.1, U2.18 (PA10)
unnamed: R14.1, U2.14 (PB1)
unnamed: R15.1, U2.3 (PF1)
unnamed: R16.1, U2.2 (PF0)
RST: J7.3, U2.4 (NRST)
RX: J8.2, U2.9 (PA3)
SWCLK: J7.1, U2.20 (PA14)
SWDIO: J7.2, U2.19 (PA13)
TX: J8.1, U2.8 (PA2)
VBUS: J1.1 (VBUS), P1.A4 (VBUS), P1.A9 (VBUS), P1.B4 (VBUS), P1.B9 (VBUS), R8.1, U1.2 (VCC), U4.2 (VCC)

Notes on the sheet:
See doc/resistorCalculator.xlsx for the values on D+ and D- pins Inspired by http://blog.deconinck.info/post/2017/08/09/Turning-a-Quick-Charge-3.0-charger-into-a-variable-voltage-power-supply
Battery Pack
Charger
Battery Connector

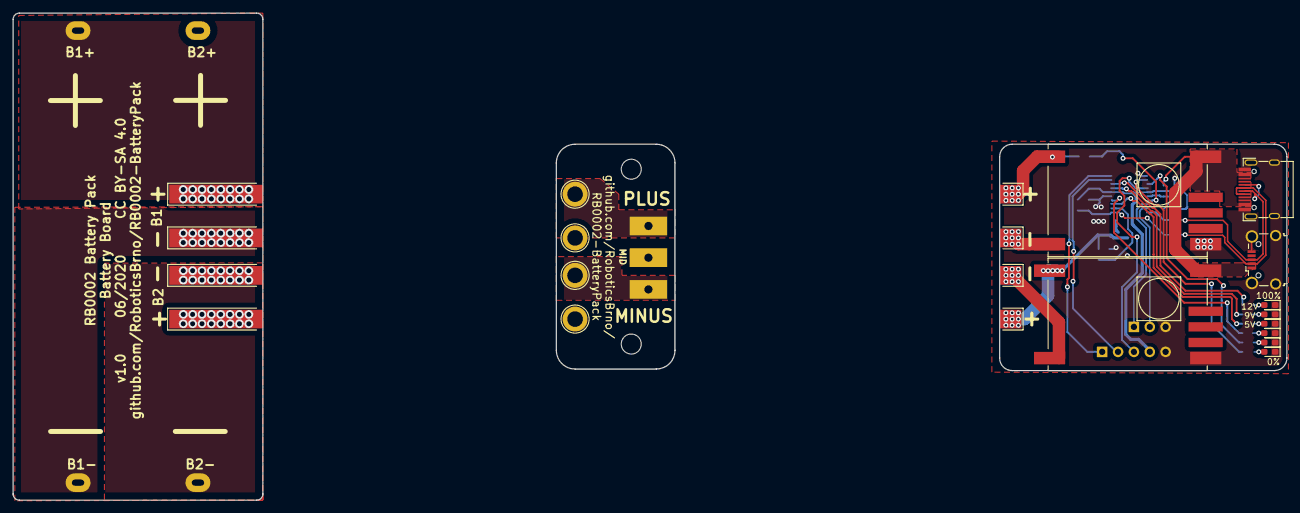
[picture p45: board batteryPack.kicad_pcb from above]

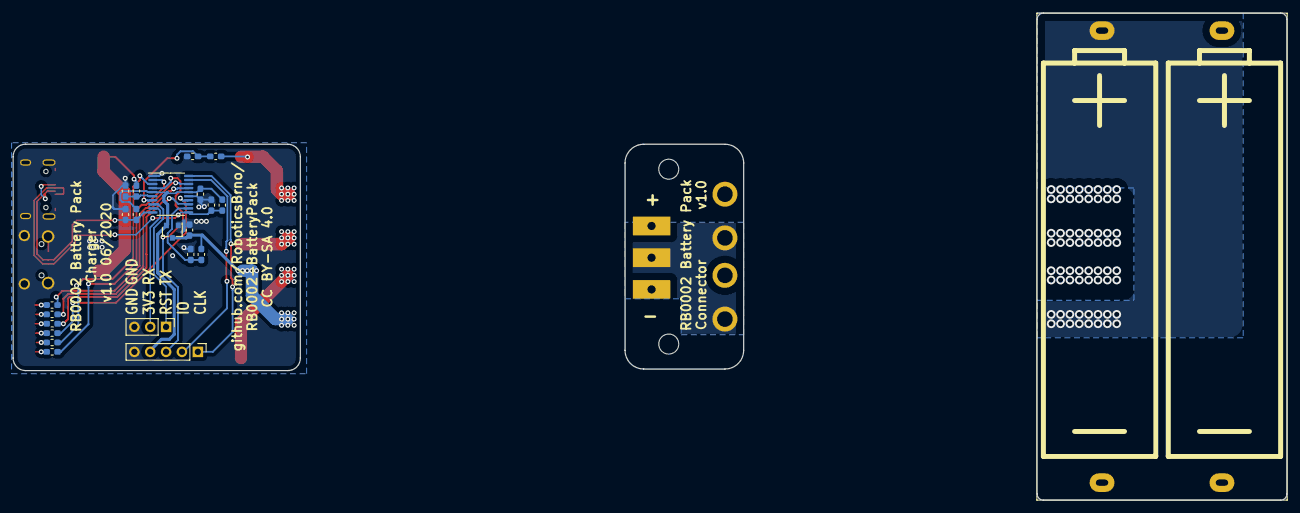
[picture p46: board batteryPack.kicad_pcb from below]

Board: 2 copper layers, 204.0 x 78.0 mm, 48 parts (23 on the bottom side), 36 nets.
