donnels/aiwa-pb-3/(commit log)

2025-12-11 first rough draft
    [pb3-pack.scad, pb3-pack.stl, pb3-replacement.kicad_pcb, pb3-replacement.kicad_sch]
2025-12-11 ci: refresh CAD outputs
    [mechanical_pb3-pack.stl]
2025-12-11 now lets pipe that rough draft through the ci cd pipe
    [pb3-pack.scad, pb3-pack.stl]
2025-12-11 ci: refresh outputs
    [pb3-pack.stl]
2025-12-11 pre cleanup
    [pb3-replacement.kicad_sch]
2025-12-12 debug added
    [pb3-pack.stl]
2025-12-12 ci: render all outputs [skip ci]
    [pb3-pack.stl]
2025-12-13 test with hellor world
    [led-blinker.kicad_pcb, led-blinker.kicad_sch]
2026-09-06 Create PB-3 PCB layout and KiBot outputs
    [pb3-replacement.kicad_pcb]
2026-09-06 Finalize DRC-clean PB-3 board layout
    [pb3-replacement.kicad_pcb]
2026-09-06 Add ngspice PB-3 circuit emulation
2026-09-06 docs: fix resistor-value inconsistency between kicad and research READMEs
2026-09-06 docs: clarify resistor/voltage relationship direction
2026-09-06 docs: de-duplicate ngspice values, add derived resistor estimate
2026-09-06 docs: clarify ngspice model uses idealized 2.0V, not the derived resistor estimate
2026-09-06 feat: add KiCad 3D exports, STL fit-check, and free training links
    [include-pb3-envelope.scad, pb3-fit-check.scad, pb3-pack.scad]
2026-09-06 ci: containerize GLB→STL step, add container READMEs, trim prose
2026-09-06 Route PB-3 PCB nets/traces; add copper for power path
    [pb3-replacement.kicad_pcb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]
2026-09-07 Split circuit emulation into two-stage model (architecture sizing vs schematic-derived)
2026-09-07 Wire pb3-replacement schematic with real symbols, unblock Stage 2 netlist export
    [pb3-replacement.kicad_sch]
