donnels/aiwa-pb-3/(notices)

Notices in the files:
kicad-hello-world/batteryPack.kicad_pcb:
CC BY-SA 4.0
v1.0 06/2020 CC BY-SA 4.0
kicad/pb3-replacement.kicad_sch:
Open source - CC BY-SA 4.0
results/docs/README.html:
Asciidoctor default stylesheet | MIT License | https://asciidoctor.org
